theengineeraccelerator/Arduino-DDS/1 Product Definition/Feature Block Diagram.pdf

# DDS Tone Shield Feature Block Diagram Introduction:

This diagram shows the relationship between the different event
blocks that appear in the feature list. Dashed lines represent
device boundries, blocks that touch the device boundary are accessable by the user.

External Power
Power
Wired Signal
Wireless Signal

# KEY

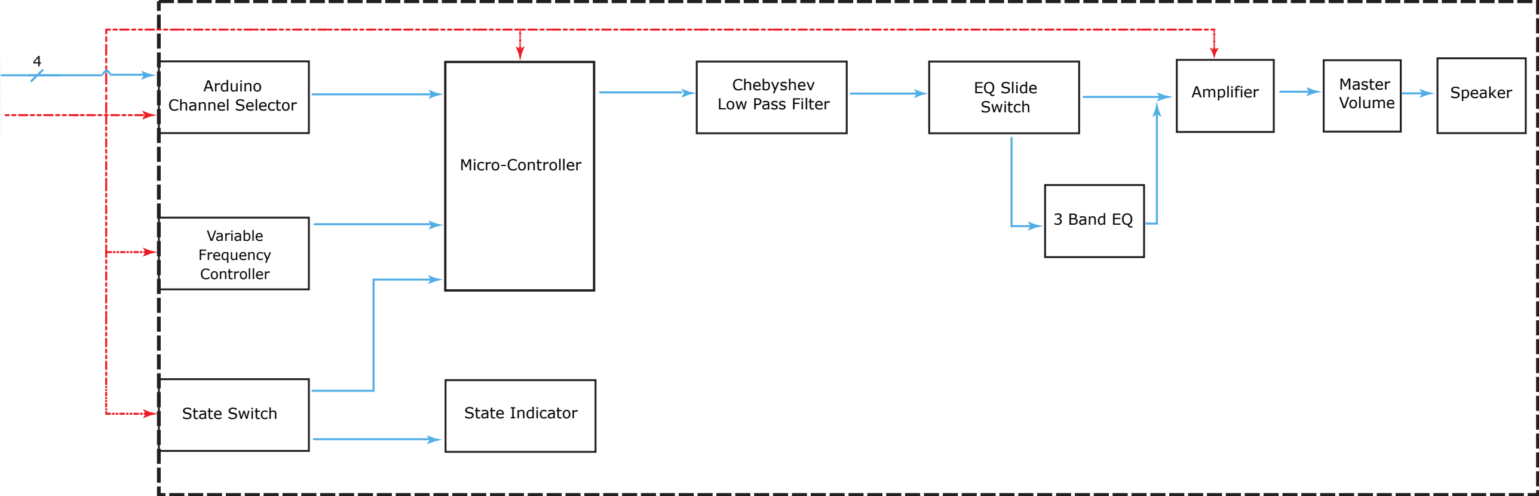
[picture p1: figure]
3 Band EQ; Arduino Channel Selector; Variable Frequency Controller; State Switch; Micro-Controller; State Indicator; Chebyshev Low Pass Filter; EQ Slide Switch; Amplifier; Speaker Master; Volume

Computer | Arduino Uno

## Circuit Board
