theengineeraccelerator/Arduino-DDS/2 Architecture/Product Architecture.xlsx

Sheet: Major Signals List
Project | Arduino DDS Breakout Board Hardware Block Diagram
Author | Zacher Tiburzi
Date | 2017-05-27
Verison | V_03
Name | Max Voltage | Current | Type | Max frequency | Copper Weight | Min Trace Width | Max length | Notes
Serial PC-Uno Signal | 5v |  | Digital | N/A
ATTiny Program 1 Signal | 5v | <10ma | Digital | 1kHz
ATTiny Program 2 Signal | 5v | <10ma | Digital | 1kHz
ATTiny Program 3 Signal | 5v | <10ma | Digital | 1kHz
ATTiny Program 4 Signal | 5v | <10ma | Digital | 1kHz
Uno Tone Signal 1 | 5v | <10ma | PWM | 1kHz
Uno Tone Signal 2 | 5v | <10ma | PWM | 1kHz
Uno Tone Signal 3 | 5v | <10ma | PWM | 1kHz
Uno Tone Signal 4 | 5v | <10ma | PWM | 1kHz
Uno Tone Signal Master | 5v | <10ma | PWM | 1kHz
DDS Tone Output Signal | 5v | <10ma | PWM | 320kHz
State LED Signal | 5v | <10ma | Digital | DC
On-Off State Signal | 5v | <10ma | Digital | DC
Var. Freq. Signal | 5v | <10ma | Digital | DC
LPF Signal Out | 5v | 10-40ma | Analog | 20khz
3 Band EQ Signal Out | 5v | 10-40ma | Analog | 20khz
Speaker Signal In | 2v | 25mA | Analog | 20khz
VCC | 5v | <10ma |  | DC
GND | 0v |  |  | DC

Sheet: Interface Pinouts
Project | Arduino DDS Breakout Board Hardware Block Diagram
Author | Zacher Tiburzi
Date | 2017-05-27
Verison | V_03
INTERFACE NAME
Pin Number | Pin Name | Connected Signal
Computer / Uno
1 | USB | Serial PC-Uno Signal
Uno / DDS Pin Interface
1 | Pin 13 | ATTiny Program 1 Signal
2 | Pin 12 | ATTiny Program 2 Signal
3 | Pin 11 | ATTiny Program 3 Signal
4 | Pin 10 | ATTiny Program 4 Signal
5 | Pin 9 | Uno Tone Signal 1
6 | Pin 6 | Uno Tone Signal 2
7 | Pin 5 | Uno Tone Signal 3
8 | Pin 3 | Uno Tone Signal 4
9 | VCC | VCC
10 | GND | GND
ATTIny85
1 | PB5 | ATTiny Program 4 Signal
2 | PB3 | Uno Tone Signal Master
3 | PB4 | DDS Tone Output Signal
4 | GND | GND
5 | PB0 | ATTiny Program 3 Signal / State LED Signal
6 | PB1 | ATTiny Program 2 Signal / On-Off State Signal
7 | PB2 | ATTiny Program 1 Signal / Var. Freq. Signal
8 | VCC | VCC

Sheet: Current Budget
Project | Arduino DDS Breakout Board Hardware Block Diagram
Author | Zacher Tiburzi
Date | 2017-05-27
Verison | V_03
 | Daily Duty Cycle | Current Draw [A] | Effective Avg Current [A] | Voltage Range
Attiny85 | 100% | 0.15 | 0.15 | 5v
LED | 100% | 0.02 | 0.02 | 1.4-1.9v
Var Freq POT | 50% | 0.1 | 0.05 | 1V - 5V
Push Button | 50% | 0.02 | 0.01 | 5V
Slide Switch | 100% | 0.025 | 0.025 | 5V
3 Band Eq | 50% | 0.1 | 0.05 | 6V
AMP | 100% | 0.055 | 0.055 | 6V
Total Current |  |  | 0.36

Sheet: Calculations
Project | Arduino DDS Breakout Board Hardware Block Diagram |  | Key
Author | Zacher Tiburzi |  | Inputs =
Date | 2017-05-27 |  | Outputs =
Verison | V_03
Perameters
ATTiny85 Pins (Page 161 on the atttiny85 document) | Pin output low voltage. With VCC= 5V Vout max = .6V
 | Pin output High voltage. With VCC= 5V Vout min = 4.3V
Outline of Signal Flow
1. Signal out of the ATTiny85 | 2. Signal into LPF | 3A. Wire | 4. Signal into Summing Amp | 5. Sgnal to speaker
 |  | 3B. Signal into EQ
Audio Range Notes
Sub Bass | 20 - 60
Bass | 60 - 250
Low Midrange | 250 - 500
Midrange | 500 - 2k
Upper Midrange | 2k - 4k |  |  |  |  | Random Calculations |  |  | Old Calculations
Presence | 4k - 6k |  |  |  |  | 555 Timer Frequency calculation |  |  | LPF Filter Component Design
Brilliance | 6k - 20k |  |  |  |  | R1 | 100 |  | f | 2000 | Hz
 |  |  |  |  |  | R2 | 1000 |  | R | 330 | Ω
 |  |  |  |  |  | C | 1e-07 |  | C | 2.2e-08 | F
1. Signal out of the ATTiny85 |  |  |  |  |  |  | t_high = .693(R1 + R2)C |  |  | f = 1 / (2πRC)
High voltage worst case 4.3V |  |  |  |  |  |  | t_low = .693(R2)C |  | f | 21922.81503 | Hz
Low voltage worst case .6V |  |  |  |  |  | t_high | 7.623e-05 |  | R | 3617.26448 | Ω
 |  |  |  |  |  | t_low | 6.93e-05 |  | C | 2.411509653e-07 | F
 |  |  |  |  |  |  | t = t_high + t_low
2. Signal into LPF |  |  |  |  |  | t | 0.00014553
CHebyChev Filter Component Design | http://www.rfcafe.com/references/electrical/filter-denorm.htm | http://www.calculatoredge.com/electronics/ch%20pi%20low%20pass.htm |  |  |  |  | f = 1 / t |  | LPF Voltage Output(V_High_Worst) | http://www.electronics-tutorials.ws/filter/filter_2.html |  | LPF Voltage Output(V_Low_Worst) | http://www.electronics-tutorials.ws/filter/filter_2.html
 |  |  |  |  |  | f | 6871.435443 |  | f | 2000 | Hz | f | 2000 | Hz
 |  |  |  |  |  |  |  |  | C | 2.2e-08 | F | C | 0.0000000220 | F
f_cuttoff | 12.5kHz |  |  |  |  |  |  |  |  | Xc = 1 / ((2πfC) |  |  | Xc = 1 / ((2πfC)
https://www-users.cs.york.ac.uk/~fisher/cgi-bin/lcfilter |  |  |  |  |  | Voltage Divider Analysis |  |  | Xc | 3617.26448 | Ω | Xc | 3617.26448 | Ω
http://interface.khm.de/index.php/lab/interfaces-advanced/arduino-dds-sinewave-generator/ |  | How much ripple can handle on an audio application. How much can human hear |  |  |  | Vin | 5 | V
 |  |  |  |  |  | R1 | 2 | kΩ | Vin | 4.3 | V | Vin | 0.6 | V
 |  |  |  |  |  | R2 | 2 | kΩ | R | 330 | Ω | R | 330 | Ω
3B. Signal into EQ | Note: Red tex indicates used values. |  |  |  |  |  | Vout = Vin(R2 / (R1+R2)) |  |  | Vout = Vin * (Xc / (R^2 + Xc^2)^.5) |  |  | Vout = Vin * (Xc / (R^2 + Xc^2)^.5)
LPF Filter Component Design |  |  |  |  |  | Vout | 2.5 | V | Vout | 4.282216993 | V | Vout | 0.5975186502 | V
f_cuttoff | 0 | Hz
R | 3900 | Ω
C | 2.2e-08 | F |  |  |  | Voltage Divider Design
 | f = 1 / (2πRC) |  |  |  |  | Vin | 12 | V
f_cuttoff | 1855.007426 | Hz |  |  |  | Vout | 6 | V
R | #DIV/0! | Ω |  |  |  | R2 | 5 | k
C | #DIV/0! | F |  |  |  |  | R1 = R2(Vin / Vout - 1)
 |  |  |  |  |  | R1 | 5 | k
HPF Filter Component Design
f_cuttoff | 0 | Hz |  |  |  | Ohm's Law
R | 1000 | Ω |  |  |  | V | 5 | V
C | 2.2e-08 | F |  |  |  | I | 0.001 | A
 | f = 1 / (2πRC) |  |  |  |  | R | 5 | Ω
f_cuttoff | 7234.52896 | Hz |  |  |  |  | V = I*R
R | #DIV/0! | Ω |  |  |  | V | 0.005 | V
C | #DIV/0! | F |  |  |  | I | 1 | A
 |  |  |  |  |  | R | 5000 | Ω
Cascade BPF Filter (LPF) Component Design
f_cuttoff | 0 | Hz |  |  |  | Power Calculation
R | 1000 | Ω |  |  |  | V | 5 | V
C | 2.2e-08 | F |  |  |  | I | 0.001 | A
 | f = 1 / (2πRC) |  |  |  |  | R | 330 | Ω
f_cuttoff | 7234.52896 | Hz |  |  |  |  | P = V*I
R | #DIV/0! | Ω |  |  |  | P | 0.005 | W
C | #DIV/0! | F |  |  |  |  | P = I^2*R
 |  |  |  |  |  | P | 0.00033 | W
 |  |  |  |  |  |  | P = V^2 / R
Cascade BPF Filter (HPF) Component Design |  |  |  |  |  | P | 0.07575757576 | W
f_cuttoff | 0 | Hz
R | 3900 | Ω
C | 2.2e-08 | F |  |  |  | op amp gain
 | f = 1 / (2πRC) |  |  |  |  | Rin | 680
f_cuttoff | 1855.007426 | Hz |  |  |  | Rf | 5000
R | #DIV/0! | Ω |  |  |  |  | A = Vout/Vin = Rf/Rin
C | #DIV/0! | F |  |  |  | A | 7.352941176
LPF Voltage Output (V_High_Worst) | http://www.electronics-tutorials.ws/filter/filter_2.html |  | LPF Voltage Output (V_Low_Worst) | http://www.electronics-tutorials.ws/filter/filter_2.html
f | 2000 | Hz | f | 2000 | Hz
C | 2.2e-08 | F | C | 2.2e-08 | F
 | Xc = 1 / ((2πfC) |  |  | Xc = 1 / ((2πfC)
Xc | 3617.26448 | Ω | Xc | 3617.26448 | Ω
Vin | 4.282216993 | V | Vin | 0.5975186502 | V
R | 3900 | Ω | R | 3900 | Ω
 | Vout = Vin * (Xc / (R^2 + Xc^2)^.5) |  |  | Vout = Vin * (Xc / (R^2 + Xc^2)^.5)
Vout | 2.912038666 | V | Vout | 0.4063309766 | V
HPF Voltage Output (V_High_Worst) | http://www.electronics-tutorials.ws/filter/filter_2.html |  | HPF Voltage Output (V_Low_Worst) | http://www.electronics-tutorials.ws/filter/filter_2.html
f | 2000 | Hz | f | 2000 | Hz
C | 2.2e-08 | F | C | 2.2e-08 | F
 | Xc = 1 / ((2πfC) |  |  | Xc = 1 / ((2πfC)
Xc | 3617.26448 | Ω | Xc | 3617.26448 | Ω
Vin | 4.282216993 | V | Vin | 0.5975186502 | V
R | 1000 | Ω | R | 1000 | Ω
 | Vout = Vin * (R / (R^2 + Xc^2)^.5) |  |  | Vout = Vin * (R / (R^2 + Xc^2)^.5)
Vout | 1.141028195 | V | Vout | 0.1592132365 | V
Cascade BPF Filter (LPF) Component Design (V_High_Worst) |  |  | Cascade BPF Filter (LPF) Component Design (V_Low_Worst)
f | 2000 | Hz | f | 2000 | Hz
C | 2.2e-08 | F | C | 2.2e-08 | F
 | Xc = 1 / ((2πfC) |  |  | Xc = 1 / ((2πfC)
Xc | 3617.26448 | Ω | Xc | 3617.26448 | Ω
Vin | 4.282216993 | V | Vin | 0.5975186502 | V
R | 1000 | Ω | R | 1000 | Ω
 | Vout = Vin * (Xc / (R^2 + Xc^2)^.5) |  |  | Vout = Vin * (Xc / (R^2 + Xc^2)^.5)
Vout | 4.12740076 | V | Vout | 0.5759163851 | V
f | 2000 | Hz | f | 2000 | Hz
C | 2.2e-08 | F | C | 2.2e-08 | F
 | Xc = 1 / ((2πfC) |  |  | Xc = 1 / ((2πfC)
Xc | 3617.26448 | Ω | Xc | 3617.26448 | Ω
Vin | 4.12740076 | V | Vin | 0.5975186502 | V
R | 3900 | Ω | R | 3900 | Ω
 | Vout = Vin * (R / (R^2 + Xc^2)^.5) |  |  | Vout = Vin * (R / (R^2 + Xc^2)^.5)
Vout | 3.026143021 | V | Vout | 0.4380909435 | V
4. Signal into Summing Amp
Single Signal (V_High_Worst) | Rf = 5k pot |  | Single Signal (V_Low_Worst) | Rf = 5k pot
V1 | 2.912038666 |  | V1 | 0.4063309766
V2 | 1.141028195 |  | V2 | 0.1592132365
V3 | 3.026143021 |  | V3 | 0.4380909435
V4 | 0 |  | V4 | 0
Rf | 500 | 5000 | Rf | 500 | 5000
Rin | 5600 |  | Rin | 3000
 | Vout = Rf/Rin(V1 + V2 + V3 + V4) |  |  | Vout = Rf/Rin(V1 + V2 + V3 + V4)
Vout | 0.6320723108 | 6.320723108 | Vout | 0.1672725261 | 1.672725261
EQ (V_High_Worst) | Rf = 5k pot |  | EQ (V_Low_Worst) | Rf = 5k pot
V1 | 0 |  | V1 | 0
V2 | 0 |  | V2 | 0
V3 | 0 |  | V3 | 0
V4 | 4.282216993 |  | V4 | 0.5975186502
Rf | 500 | 5000 | Rf | 500 | 5000
Rin | 3900 |  | Rin | 3000
 | Vout = Rf/Rin(V1 + V2 + V3 + V4) |  |  | Vout = Rf/Rin(V1 + V2 + V3 + V4)
Vout | 0.5490021786 | 5.490021786 | Vout | 0.0995864417 | 0.995864417
5. Length calculation
f_fund (max) | 36000 | Hz
f_harmonic (max) | 360000 | Hz
Copper Velocity factor | 0.643
Speed of light | 299792458 | m/s
Wavelength | 535 | m
 | speed = frequency • wavelength | m/s / 1 / s = m
f | 360311.3093 | Hz
length | 535.4626403 | meters
Safe length | 26.77313201 | Meters
