theengineeraccelerator/Arduino-DDS/2 Architecture/Archive/Product Architecture REV 02.xlsx

Sheet: Major Signals List
Project | Arduino DDS Breakout Board Hardware Block Diagram
Author | Douglas Bahr
Date | 2016-10-14
Verison | V_02
Name | Max Voltage | Current | Type | Max frequency | Copper Weight | Min Trace Width | Max length
Ardu to Tiny MainSignal | 5v | <10ma |  | 1hz
Tiny To Led Signal Out | 5v | 15ma |  | 20hz
Manual Frequency Signal | 5v | <10ma |  | 1kHz
Tiny DDS Signal Out | 5v | 25-40ma |  | 50kHz
Ard Sig header Pin 11 | 5v | <10ma |  | 1kHz
Ard Sig header Pin 10 | 5v | <10ma |  | 1kHz
Ard Sig header Pin 9 | 5v | <10ma |  | 1kHz
Ard Sig header Pin 4 | 5v | <10ma |  | 1kHz

Sheet: Pinouts
Project | Arduino DDS Breakout Board Hardware Block Diagram
Author | Douglas Bahr
Date | 2016-10-14
Verison | V_02
COMPONENT NAME | Pin Name
HDR1
 | io11
 | io10
 | io9
HDR4
 | io4
HDR2
 | VCC
 | GND
Attiny85
 | Tiny_2
 | Tiny_Vcc
 | Tiny_GND
DIP Switch
 | Dip_1
 | Dip_2
 | Dip_3
 | Dip_4
 | Dip_16
 | Dip_15
 | Dip_14
 | Dip_13

Sheet: Current Budget
Project | Arduino DDS Breakout Board Hardware Block Diagram
Author | Douglas Bahr
Date | 2016-10-14
Verison | V_02
 | Daily Duty Cycle | Current Draw [A] | Effective Avg Current [A] | Voltage Range
Attiny85 | 100% | 0.15 | 0.15 | 5v
LED | 100% | 0.02 | 0.02 | 1.4-1.9v
Total Current | 170ma

Sheet: Calculations
Project | Arduino DDS Breakout Board Hardware Block Diagram
Author | Douglas Bahr
Date | 2016-09-28
Verison | V_02
Attiny max out power | 100mw
Max draw | 200mw
power disapated by 5kpot |  | v/r = I across res | 5v/5000ohm | .001 I | P= i^2*R | 5nWatt
RC Low pass filter Cutoff 20KHz
 | 270 | ohm
 | 2.948808681e-08 | farad
 | 20000 | cutoff freq
 | 269.8710807
 |  | SOURCE
RC filter impedence |  | http://www.electronics-tutorials.ws/filter/filter_2.html
 | 381.746513 | Ohm
 |  | SOURCE
 |  | http://www.rfcafe.com/references/electrical/filter-denorm.htm
 | 8.691320734e-16 | Farad
 | 0.8202285378 | Henery | This seems to be completely off and discarded
 |  | http://www.calculatoredge.com/electronics/ch%20pi%20low%20pass.htm
Chebyshev Low pass filter calculations | l1 | 8.97512 | uH
 | l2 | 8.97512 | uH
 | c2 | 25.24322 | uF
 | c3 | 20.42218 | uF
