theengineeraccelerator/Arduino-DDS/2 Architecture/Archive/Product Architecture.xlsx

Sheet: Major Signals List
Project | Arduino DDS Breakout Board Hardware Block Diagram
Author | Douglas Bahr
Date | 2016-09-28
Verison | V_01
Name | Max Voltage | Current | Type | Max frequency | Copper Weight | Min Trace Width | Max length
Attiny85 | 6v | 200mA |  | 64mHz
DIP Switch | 24v | 100mA
Speaker | 5v | 20mA |  | 20KHZ
POT | 50 Vac | 10mA
On/On Switch | 28v | .4VA
LED | 1.7v | 50mA

Sheet: Pinouts
Project | Arduino DDS Breakout Board Hardware Block Diagram
Author | Douglas Bahr
Date | 2016-09-28
Verison | V_01
COMPONENT NAME
Pin Number | Pin Name
Attiny85 | Tiny_Power
 | Tiny_GND
 | Pot_In
 | On/on_IN
 | Sine_Out
DIP Switch | 11in
 | 10in
 | 9in
 | 3in
 | DIP_Out
Speaker | Speaker_Signal_Input
 | Speaker_Signal_Out
POT | Pot_Power
 | Pot_Gnd
 | Resistance_signal
On/On Switch | On/On_Power
 | On/On_Gnd
 | State
LED | Led_Power
 | Led_Gnd

Sheet: Current Budget
Project | Arduino DDS Breakout Board Hardware Block Diagram
Author | Douglas Bahr
Date | 2016-09-28
Verison | V_01
 | Daily Duty Cycle | Current Draw [A] | Effective Avg Current [A] | Voltage Range
Attiny85 | 100% | 0.15 | 0.15 | 5v
(Attiny might draw negligable current from its digital in pins. I don't know how attiny handles it)
Total Current | 150ma

Sheet: Calculations
Project | Arduino DDS Breakout Board Hardware Block Diagram
Author | Douglas Bahr
Date | 2016-09-28
Verison | V_01
Attiny max out power | 100mw
Max draw | 200mw
power disapated by 5kpot |  | v/r = I across res | 5v/5000ohm | .001 I | P= i^2*R | 5nWatt
 |  |  |  |  |  | http://www.electronics-tutorials.ws/filter/filter_2.html
 |  | rc
 |  | 270 | ohm |  | RC filter impedence
 |  | 2.948808681e-08 | farad |  | 381.746513
 |  | 20000 | cutoff freq
 |  |  |  | 8.691320734e-16 |  |  | 269.8710807
 |  |  |  | 0.8202285378
 |  |  |  |  | http://www.rfcafe.com/references/electrical/filter-denorm.htm
 | http://prntscr.com/cs9gem
 | l1 | 8.97512 | uH
 | l2 | 8.97512 | uH
 | c1 | 20.42218 | uf
 | c2 | 25.24322 | uf
 | c3 | 20.42218 | uf
