theengineeraccelerator/Arduino-DDS/1 Product Definition/Feature Block Diagram.png

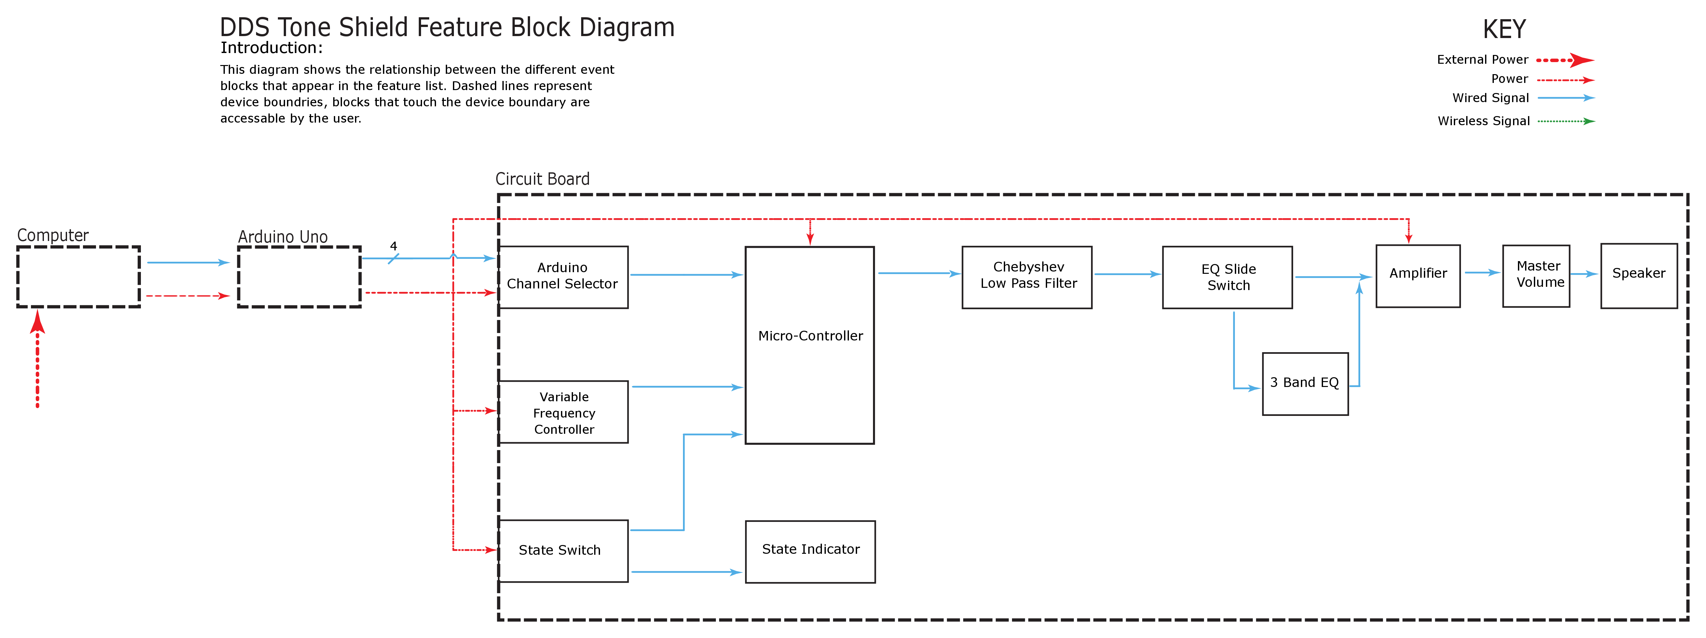
1 Product Definition/Feature Block Diagram.png
