theengineeraccelerator/Arduino-DDS/2 Architecture/Hardware Block Diagram.png

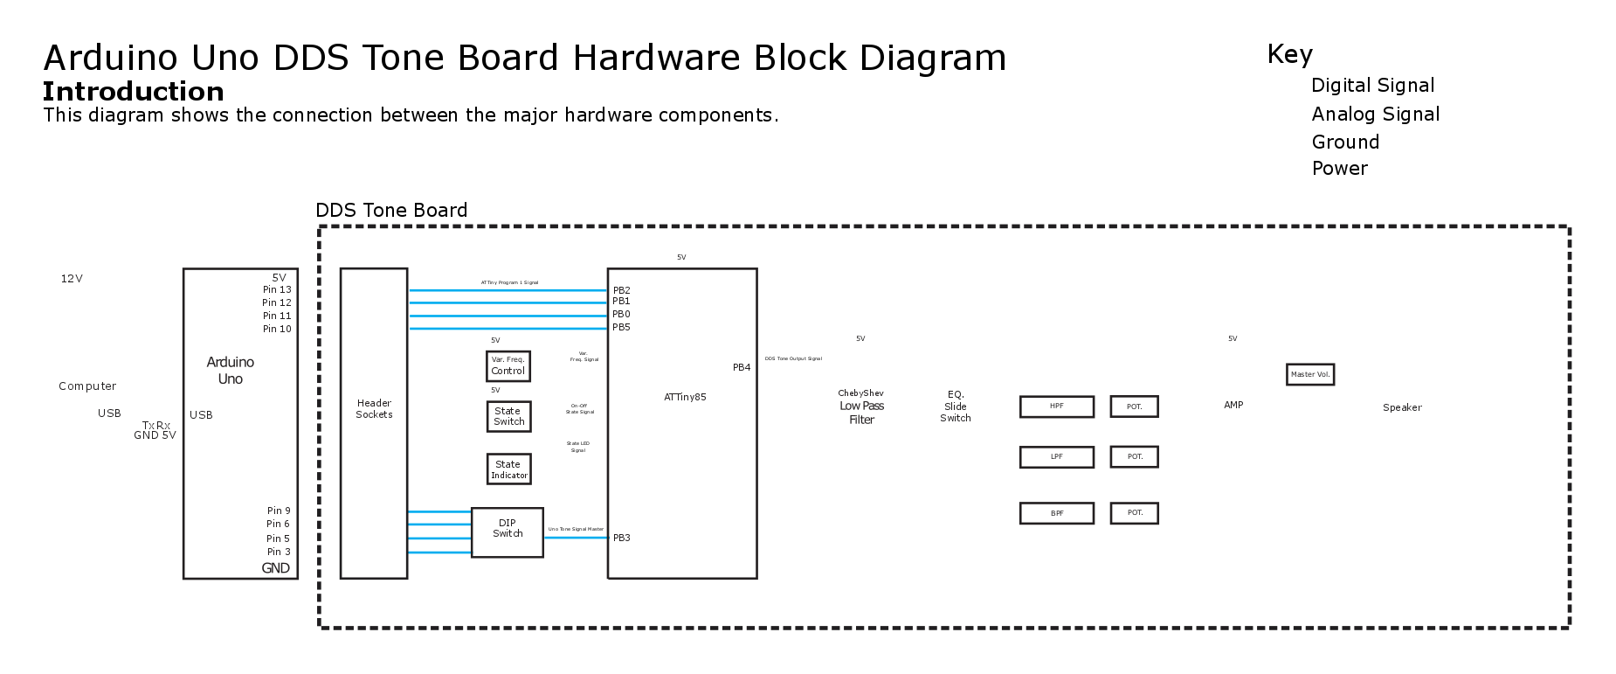
2 Architecture/Hardware Block Diagram.png
