theengineeraccelerator/Arduino-DDS/Art/490 5k fft.png

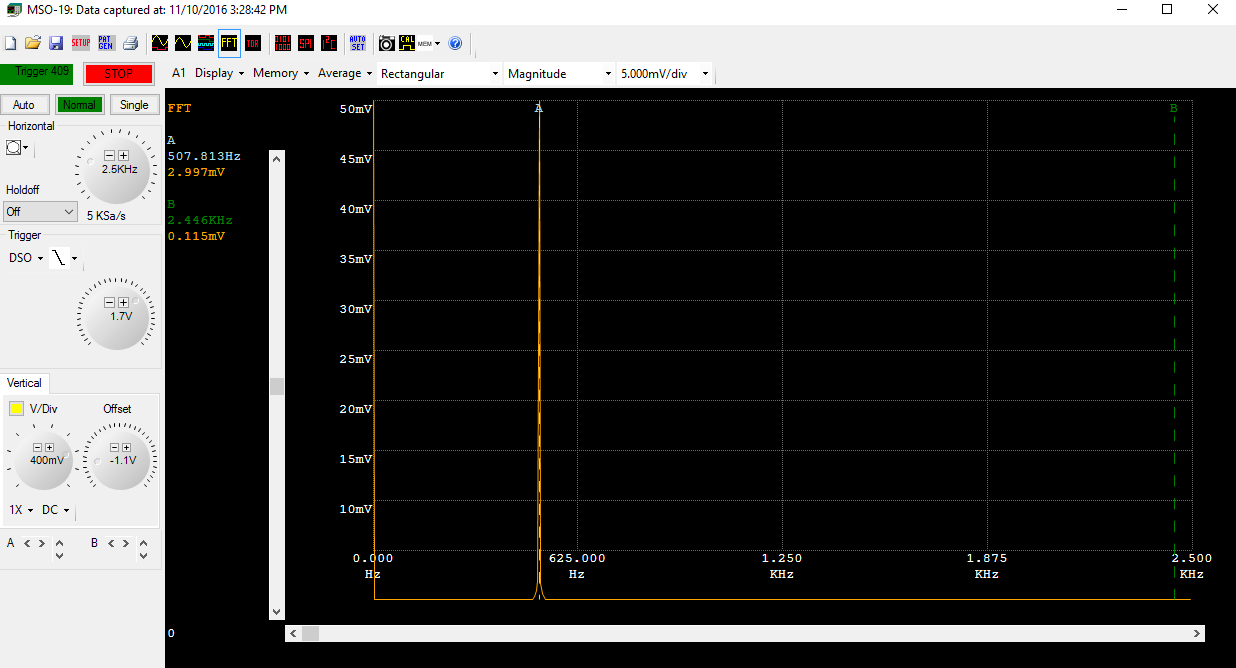
Art/490 5k fft.png
