theengineeraccelerator/Arduino-DDS/Art/490 500 fft.png

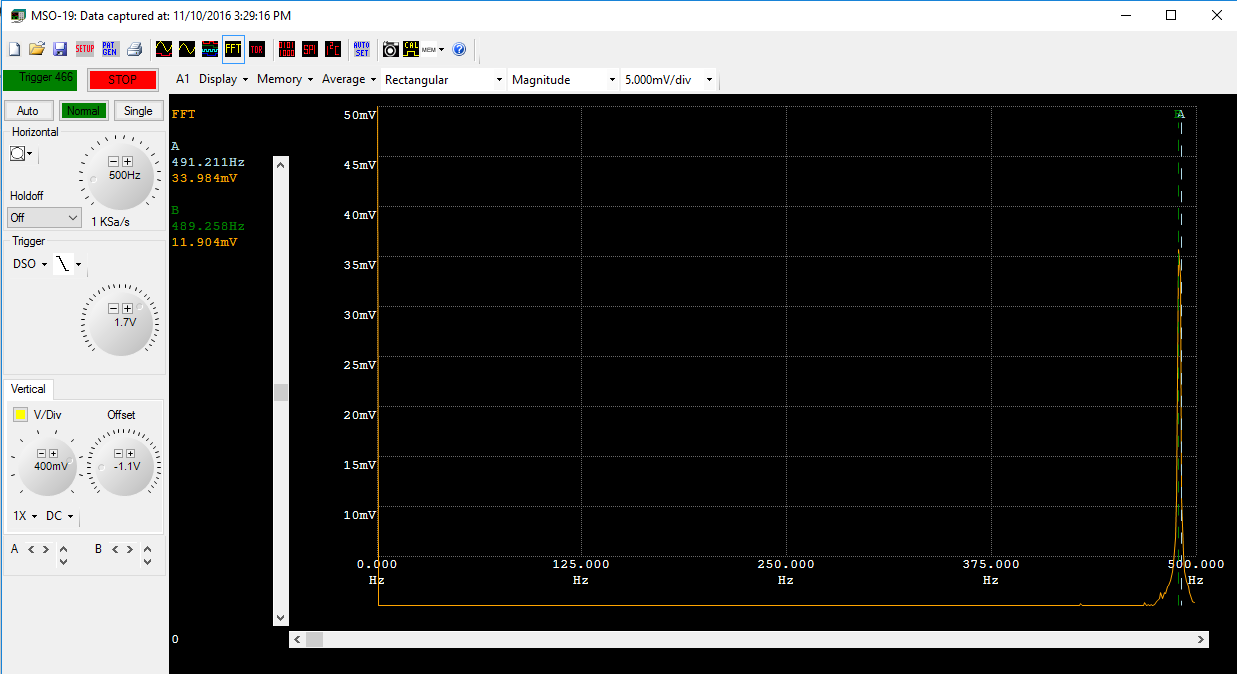
Art/490 500 fft.png
