theengineeraccelerator/Arduino-DDS/Art/490 500k fft.png

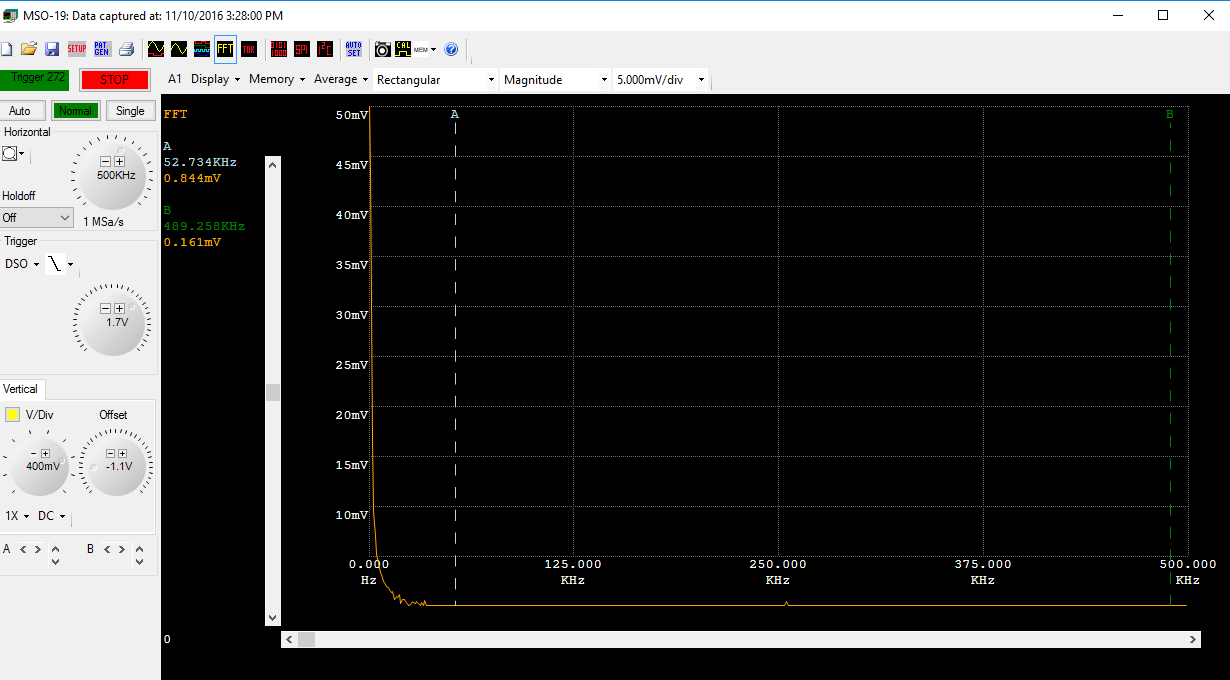
Art/490 500k fft.png
