theengineeraccelerator/Arduino-DDS/Art/490 hzScreenshot_1.png

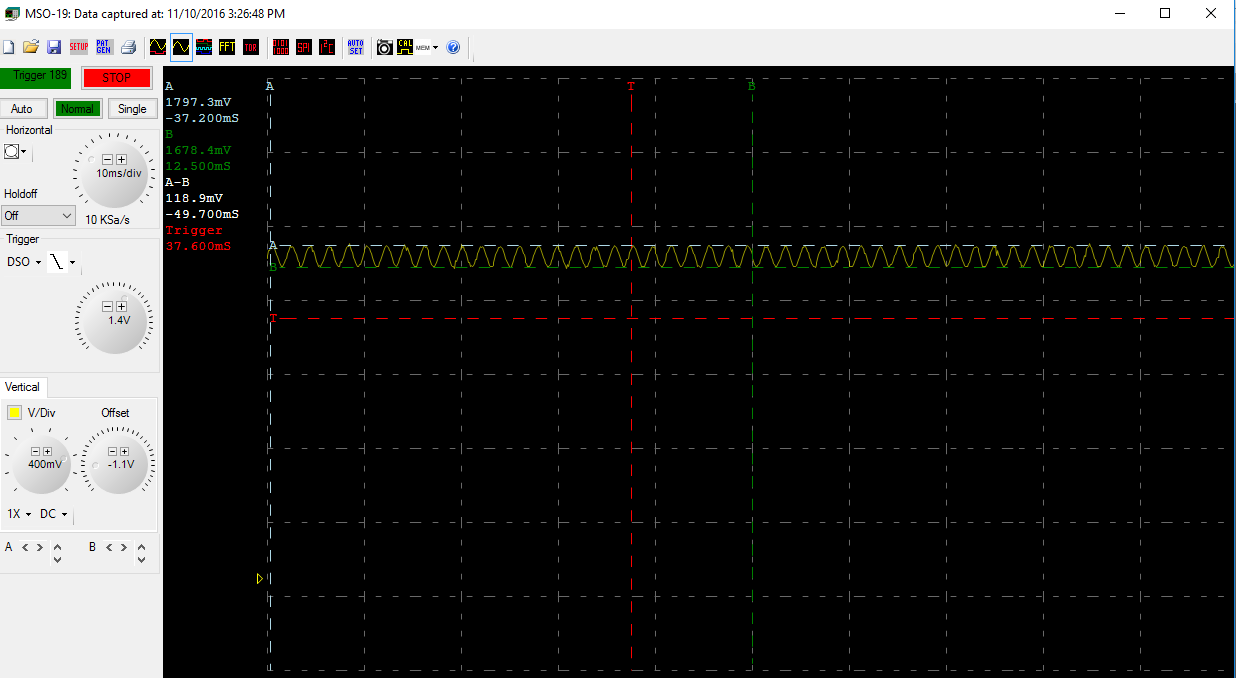
Art/490 hzScreenshot_1.png
