theengineeraccelerator/Arduino-DDS/2 Architecture/Major Component BOM.xlsx

Sheet: Major Components
Project | DDS Tone Shield |  |  |  |  |  |  |  | Key: | Finished
Author | Zacher Tiburzi |  |  |  |  |  |  |  |  | Needs an Eagle Library
Date | 42882 |  |  |  |  |  |  |  |  | Need to find Vendor part
Verison | Rev_4
Component | Voltage | Current | Tolerance | Wattage | Vendor | Vendor Part Number | Price | Qty | Manufacturer | MFG Part Number | Eagle Library: Device - Package | Invetory | URL | URL Refrence | URL Refrence
Arduino Uno Schield |  |  |  |  |  |  |  |  |  |  | ARDUINO_SHIELD - DUEMILANOVE_SHIELD | Yes
Headers that Match Arduino |  |  |  |  |  |  |  |  |  |  | CONN_6 - 1X6, CONN_8 - 1X8, CONN_10 - 1X10 | Yes | http://www.mouser.com/ProductDetail/SparkFun/PRT-11417/?qs=sGAEpiMZZMuWWq7rhECaKREdwluNxBetc4EOoXderyo%3d | https://www.sparkfun.com/products/11417
4 Pin Dip |  |  |  |  |  |  |  |  |  |  | DIP-04 - DIPSWITCH-04-SMD | Yes | http://www.mouser.com/ProductDetail/CTS-Electronic-Components/219-4MST/?qs=qNzHFtQhdJ8xGV2Z9mul9A%3D%3D | http://www.mouser.com/ProductDetail/Omron-Electronics/A6HF-4102/
Led |  |  |  |  |  |  |  |  |  |  | LED BLUE - 1206 - SMD1206 | Yes | http://www.mouser.com/ProductDetail/Lite-On/LTST-C150TBKT/?qs=V5GnFgTbEjKBpGvLUaHAfw%3D%3D | http://www.mouser.com/ProductDetail/Cree-Inc/XPGDRY-L1-0000-00501/ | https://www.digikey.com/product-detail/en/LTST-C150KRKT/160-1405-2-ND/386761
Pushbutton |  |  |  |  |  |  |  |  |  |  | PUSHBUTTON - 3CSH9_MEC_PUSHBUTTON | Yes | http://www.mouser.com/ProductDetail/MEC-Switches/3CSH9/
ATTiny |  |  |  |  |  |  |  |  |  |  | ATTINY85 - PDIP08_300MIL | Yes | http://www.mouser.com/ProductDetail/Atmel/ATtiny85-20PU/?qs=8jWQYweyg6NCiiaOb5GI9Q%3D%3D
Amp LM386N-1 |  |  |  |  |  |  |  |  |  |  | LM386 - DIP08 | Yes | http://www.mouser.com/ProductDetail/Texas-Instruments/LM386N-1-NOPB/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
ATTiny / Amp Connector |  |  |  |  |  |  |  |  |  |  | CONN_4 - 1X4 | Yes | http://www.mouser.com/ProductDetail/Mill-Max/110-44-308-41-001000/ | http://www.mouser.com/ProductDetail/Harwin/M22-7130642/ | http://www.mouser.com/Search/ProductDetail.aspx?qs=ulE8k0yEMYbeS53C36LLIQ%3d%3d | http://www.mouser.com/ProductDetail/SparkFun/PRT-00115/?qs=WyAARYrbSnbK8S6xiDKwZg%3D%3D
slide switch |  |  |  |  |  |  |  |  |  |  | SWITCH-SPDT - JS102011SCQN | Yes | http://www.mouser.com/ProductDetail/CK-Components/JS102011SCQN/?qs=aIxPIZZxLh%2FC%2Fw7UJtfwsg%3D%3D | http://www.mouser.com/ProductDetail/CK-Components/JS202011SCQN/
Speaker Jumper |  |  |  |  |  |  |  |  |  |  | CONN_2 - 1X2 | Yes | http://www.mouser.com/ProductDetail/3M-Electronic-Solutions-Division/929870-01-02-RA/
Speaker |  |  |  |  |  |  |  |  |  |  | SPEAKER - CSS40408N | Yes | http://www.mouser.com/ProductDetail/CUI/CSS-40408N/
Pot 5k |  |  |  |  |  |  |  |  |  |  | POT1 - Rk09 | Yes | http://www.mouser.com/ProductDetail/ALPS/RK09K1130AU2/?qs=sGAEpiMZZMtC25l1F4XBU3JeeCo7XMTlDNJzm3UqYmI%3d | http://www.mouser.com/ProductDetail/ALPS/RK09L1140A2U/?qs=sGAEpiMZZMtC25l1F4XBU3JeeCo7XMTlNRqBfUrZdf0%3d
Pot 10k |  |  |  |  |  |  |  |  |  |  | POT1 - Rk09 | Yes | http://www.mouser.com/ProductDetail/ALPS/RK09K1130AJ3/?qs=sGAEpiMZZMtC25l1F4XBU3JeeCo7XMTlfiaf8FqSguo%3d |  | http://www.mouser.com/ProductDetail/ALPS/RK09L1140A65/?qs=sGAEpiMZZMtC25l1F4XBUyOcKw5CnqLBmPAtssq3n28%3d
POT 100k |  |  |  |  |  |  |  |  |  |  | POT2 - 5150500311 | TODO | http://www.mouser.com/ProductDetail/ALPS/RK09D113AF25A15/ | http://www.mouser.com/ProductDetail/TE-Connectivity/5150500311/
Res 2200 |  |  |  |  |  |  |  |  |  |  | RESISTOR - 1206 | Yes | http://www.mouser.com/ProductDetail/Vishay/CRCW12062K20JNEA/
Res 330 |  |  |  |  |  |  |  |  |  |  | RESISTOR - 1206 | Yes | http://www.mouser.com/ProductDetail/Vishay/CRCW1206330RJNEB/?qs=sGAEpiMZZMvdGkrng054t1VbmbR8V6nMPxFPu6gLR8M%3d | http://www.mouser.com/ProductDetail/Vishay/CRCW2512330RJNEG/
Res 3900 |  |  |  |  |  |  |  |  |  |  | RESISTOR - 1206 | Yes | http://www.mouser.com/ProductDetail/Vishay/CRCW12063K90JNEA/?qs=sGAEpiMZZMvdGkrng054txEw7b1YnvGu19MLK7JIJYQ%3d | http://www.mouser.com/ProductDetail/Vishay/CRCW25123K90JNEG/
Res 1000 |  |  |  |  |  |  |  |  |  |  | RESISTOR - 1206 | Yes | http://www.mouser.com/ProductDetail/Vishay/CRCW12061K00JNEB/ | http://www.mouser.com/ProductDetail/Vishay/CRCW25121K00JNEG/
Res 5600 |  |  |  |  |  |  |  |  |  |  | RESISTOR - 1206 | Yes | http://www.mouser.com/ProductDetail/Vishay/CRCW12065K60JNEB/?qs=sGAEpiMZZMvdGkrng054txEw7b1YnvGuJI6O9VwCEo8%3d | http://www.mouser.com/ProductDetail/Vishay/CRCW25125K60JNEG/?qs=sGAEpiMZZMtlubZbdhIBIKccH9tYRGHhxWVoSRHblPQ%3d
Res 270 |  |  |  |  |  |  |  |  |  |  | RESISTOR - 1206 | Yes | http://www.mouser.com/ProductDetail/Vishay/CRCW1206270RJNEB/
Capacitor 22NF |  |  |  |  |  |  |  |  |  |  | CAP_POL - EIA3216 | Yes | http://www.mouser.com/ProductDetail/KEMET/C1206C223J1RACTU/ | http://www.mouser.com/ProductDetail/KEMET/C0402C222J8JACTU/?qs=sGAEpiMZZMuMW9TJLBQkXpko7Z6FbucJaU3OOvany2c%3d
Capacitor .1uF | 100nF |  |  |  |  |  |  |  |  |  |  | CAP_POL - EIA3216 | Yes | http://www.mouser.com/ProductDetail/KEMET/C1206C104K5RACTU/
Cap 47nf |  |  |  |  |  |  |  |  |  |  | CAP_POL - EIA3216 | Yes | http://www.mouser.com/ProductDetail/KEMET/C1206C473K5RAC/?qs=sGAEpiMZZMvsSlwiRhF8qiXSXURM2pKqAgxNh0rYBeU%3d
Ind 4.7mh |  |  |  |  |  |  |  |  |  |  | INDUCTOR - SDR0805-472KL | Yes | http://www.mouser.com/ProductDetail/Bourns/SDR0503-472JL/
 | notes
 | Convert between time and frequency domain
 | construct any signal out of sin and cos
 | the filted removes the n order harmonics so se end up with one.
 | Use a bunch of pulses going wide and long to create a sine wave.
 | Cheby removes the extra harmonics

Sheet: Component Comparision
Project | DDS Tone Shield |  |  |  | NOTE: Add more characteristic categories as needed
Author | Zacher Tiburzi
Date | 2017-05-27
Verison | Rev_4
Component | Voltage | Current | Tolerance | Wattage | Characteristic 1 | Characteristic 2 | Characteristic 3 | Vendor | Vendor Part Number | Price | Qty | Lead Time | Manufacturer | MFG Part Number
Speaker | 5V | 20mA |  | .1w | Mouser | 490-GF0401M | 4.81 | 1 | CUI | GF0401M
Speaker | 2V | .25A |  | .5W | Mouser | CLS0231MA-1-L152
Notes: RLC Filter Components
 | R | C | Pot |  | R | C | L | Pot
LPF |  |  |  |  | 270 | 47nF | 4.7mH
 |  |  |  |  |  | 100nF | 4.7mH
 |  |  |  |  |  | 47nF
 |  |  |  |  | 270 |  |  | 100k
LPF | 3900 | 22NF | 10K
HPF | 1000 | 22NF | 10K
BPF | 3900 | 22NF | 10K
 | 1000 | 22NF
AMP | 2200
 | 2200
 | 2200
 | 5K
