theengineeraccelerator/Arduino-DDS/2 Architecture/Archive/DDS Tone Shield Major Component BOM  REV 03.xlsx

Sheet: Major Components
Project | DDS Tone Shield
Author | Douglas Bahr
Date | 2016-10-14
Verison | Rev_3
Component | Voltage | Current | Tolerance | Wattage | Vendor | Vendor Part Number | Price | Qty | Manufacturer | MFG Part Number
Attiny85 | 5.5v | 200ma | NA | 1W | Mouser | 556-ATTINY85-20PU | 2.35 | 1 | Atmel (http://www.mouser.com/atmel/) | ATtiny85-20PU
Switch | 28v |  | na |  | Mouser | 633-BB16APFA | 4.15 | 1 | NKK Switches (http://www.mouser.com/NKK-Switches/) | BB16AP-FA
5k Pot | 25v |  | 20% | 50mw | Mouser | 858-P120PK-F20BR5K | 0.26 | 1 | BI Technologies / TT Electronics (http://www.mouser.com/BI-Technologies/) | P120PK-F20BR5K
Speaker | 5V | 20mA |  | .1w | Mouser | 490-GF0401M | 4.81 | 1 | CUI | GF0401M
DipSwitch | 50v | 100 |  |  | Mouser | 611-TDA08H0SB1R | 2.88 | 1 | C&K Components (http://www.mouser.com/ckcomponents/) | TDA08H0SB1R
100k pot | 25v |  |  | 200mW | Mouser | 279-5150500311 | 1.97 | 1 | TE Connectivity / Holsworthy (http://www.mouser.com/TE-Holsworthy/) | 5150500311
 |  |  |  |  |  | Total | 14.45

Sheet: Component Comparision
Project |  |  |  |  | NOTE: Add more characteristic categories as needed
Author
Date
Verison
Component | Voltage | Current | Tolerance | Wattage | Characteristic 1 | Characteristic 2 | Characteristic 3 | Vendor | Vendor Part Number | Price | Qty | Lead Time | Manufacturer | MFG Part Number
