theengineeraccelerator/Arduino-DDS/2 Architecture/BOM__rev_2.xlsx

Sheet: Major Components
Project | DDS Tone Shield
Author | Douglas Bahr
Date | 2016-10-20
Verison | Rev_3
Component | Voltage | Current | Tolerance | Wattage | Vendor | Vendor Part Number | Price | Qty | TOTAL | Manufacturer | MFG Part Number | Web
10 uH Inductor |  | 230 mA | 10% |  | Mouser | 871-B78108T1103K | 0.39 | 2 | 0.78 | EPCOS / TDK (http://www.mouser.com/EPCOS/) | B78108T1103K | http://www.mouser.com/ProductDetail/EPCOS-TDK/B78108T1103K/
4.7uH Inductor |  | 530 mA | 5% |  | Mouser | 542-78F4R7-RC | 0.22 | 2 | 0.44 | Bourns (http://www.mouser.com/bourns/) | 78F4R7J-RC | http://www.mouser.com/ProductDetail/Bourns/78F4R7J-RC/
100 pf capacitor | 25 VDC |  | 5% |  | Mouser | 77-VJ1206A101JXXPBC | 0.1 | 3 | 0.3 | Vishay / Vitramon | VJ1206A101JXXPW1BC | http://www.mouser.com/ProductDetail/Vishay-Vitramon/VJ1206A101JXXPW1BC/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
47nF capacitor | 16 VDC |  | 10% |  | Mouser | 77-VJ1206Y473KXJPBC | 0.1 | 2 | 0.2 | Vishay / Vitramon | VJ1206Y473KXJPW1BC | http://www.mouser.com/ProductDetail/Vishay-Vitramon/VJ1206Y473KXJPW1BC/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
100nF capacitor | 50v |  | 10% |  | Mouser | 581-12065C104K | 0.1 | 1 | 0.1 | AVX | 12065C104KAT2A | http://www.mouser.com/ProductDetail/AVX/12065C104KAT2A/?qs=sGAEpiMZZMs0AnBnWHyRQMaLe2bV4MePwTw1OreXLjM%3d
100k pot | 25v |  |  | 200mW | Mouser | 279-5150500311 | 1.97 | 1 | 1.97 | TE Connectivity / Holsworthy (http://www.mouser.com/TE-Holsworthy/) | 5150500311 | http://www.mouser.com/ProductDetail/TE-Connectivity/5150500311/
 |  |  |  |  |  |  |  |  | Total
 |  |  |  |  |  |  |  |  | 3.79

Sheet: Component Comparision
Project |  |  |  |  | NOTE: Add more characteristic categories as needed
Author
Date
Verison
Component | Voltage | Current | Tolerance | Wattage | Characteristic 1 | Characteristic 2 | Characteristic 3 | Vendor | Vendor Part Number | Price | Qty | Lead Time | Manufacturer | MFG Part Number
