theengineeraccelerator/Arduino-DDS/3 Realization/BOM/Working BOM Template.xlsx

Sheet: Eagle Internal BOM
Part | Value | DESCRIPTION | MANUFACTURER | MFG_PART_NUM | PACKAGE | VENDOR | VENDOR_PART_NUM

Sheet: Working BOM
Part | Value | Description | Manufacturer | MFG_Part_Number | Package | Vendor | Vendor_Part_num

Sheet: Back Annotation Script
CHANGE DISPLAY OFF; | Attribute Description ''; | Attribute Manufacturer ''; | Attribute MFG_Part_Number ''; | Attribute Package ''; | Attribute Vendor ''; | Attribute Vendor_Part_num '';
CHANGE DISPLAY OFF; | Attribute Description ''; | Attribute Manufacturer ''; | Attribute MFG_Part_Number ''; | Attribute Package ''; | Attribute Vendor ''; | Attribute Vendor_Part_num '';
CHANGE DISPLAY OFF; | Attribute Description ''; | Attribute Manufacturer ''; | Attribute MFG_Part_Number ''; | Attribute Package ''; | Attribute Vendor ''; | Attribute Vendor_Part_num '';
CHANGE DISPLAY OFF; | Attribute Description ''; | Attribute Manufacturer ''; | Attribute MFG_Part_Number ''; | Attribute Package ''; | Attribute Vendor ''; | Attribute Vendor_Part_num '';
CHANGE DISPLAY OFF; | Attribute Description ''; | Attribute Manufacturer ''; | Attribute MFG_Part_Number ''; | Attribute Package ''; | Attribute Vendor ''; | Attribute Vendor_Part_num '';
CHANGE DISPLAY OFF; | Attribute Description ''; | Attribute Manufacturer ''; | Attribute MFG_Part_Number ''; | Attribute Package ''; | Attribute Vendor ''; | Attribute Vendor_Part_num '';
CHANGE DISPLAY OFF; | Attribute Description ''; | Attribute Manufacturer ''; | Attribute MFG_Part_Number ''; | Attribute Package ''; | Attribute Vendor ''; | Attribute Vendor_Part_num '';
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
CHANGE DISPLAY OFF; | Attribute Description ''; | Attribute Manufacturer ''; | Attribute MFG_Part_Number ''; | Attribute Package ''; | Attribute Vendor ''; | Attribute Vendor_Part_num '';
