theengineeraccelerator/Arduino-DDS/3 Realization/Command List Template.xlsx

Sheet: SMS Construction
SMS Construction
Fields | @ | int-msg # | “ “ | byte part | “ “ | byte:Total Parts | : | char: payload | !
Range |  | 0 - 999 |  | 0 - 2 |  | 1 - 3 |  | 0 - 151 characters
Example Construction | @ | 21 | “ “ | 0 | “ “ | 1 | : | CFG 357541000485583 | !
Sent SMS | @21 0 1:CFG 357541000485583!

Sheet: SMS formats
XXX <-> YYY Command List
Author
Date
Version
Key: |  |  | General parsing characters |  |  |  | NOTE: | “ “: means a whitespace character
 |  |  | “ “ | Command End
 |  |  | ; | record separator
 |  |  | , | non time field separator
 |  |  | / | time separator
COMMAND NAME |  |  | Report Date
Fields | RPT | “ “ | int:day | / | int:month | / | int:year | ;
 |  |  |  |  |  |  |  |  | char reason | , | int:day | / | int:month | / | int:year | , | int: item-id | , | char:lot-id | , | int:qty
Range |  |  | 0 - 31 |  | 0 - 12 |  | 00 - 99 |  | USE,WST, EXP,INC,DEC |  | 0 - 31 |  | 0 - 12 |  | 00 - 99 |  | See Inventory ID Table |  | See Lot Id format |  | 0 - 999999
 |  |  |  |  |  |  |  |  | OR
 |  |  |  |  |  |  |  |  | RCV,SNT |  |  |  |  |  |  |  | int: to/from locn-id? |  | char:ship-id?
Range |  |  |  |  |  |  |  |  |  |  |  |  |  |  |  |  | 0 - 32,000 |  | See ship voucher format | ,
Example Construction | RPT | “ “ | 30 | / | 04 | / | 12 | ; | USE | , | 29 | / | 04 | / | 12 | , | 01 | , | 320 | , | 10
 |  |  |  |  |  |  |  | ; | USE | , | 24 | / | 04 | / | 12 | , | 04 | , | V-JM-010211E | , | 5
 |  |  |  |  |  |  |  | ; | RCV | , | 10 | / | 04 | / | 12 | , | 03 | , | X11064 | , | -1
Sent SMS | RPT 30/04/12;USE,29/04/12,01,320,10;USE,24/04/12,04,V-JM-010211E,5;RCV,10/04/12,03,X11064,-1
Notes | For The SNT case the first field is the location the shipment was sent to and in the RCV case the first field is the location the shipment was received from
