theengineeraccelerator/Arduino-DDS/3 Realization/IC Tables.xlsx

 | create pads | smd .1 .1 '1
Pad | Name | Rename Pins | X Coord | Y Coord | Move Pads | Connect Pins
1 | A | name 1 A; | 0.2 | 0.4 | move 1 (0.2 0.4); | Connect G$1.A 1;
2 | B | name 2 B; | 0.3 | 0.7 | move 2 (0.3 0.7); | Connect G$1.B 2;
3 | C | name 3 C; | 0.4 | 1.4 | move 3 (0.4 1.4); | Connect G$1.C 3;
4 | D | name 4 D; | 0.5 | 1.7 | move 4 (0.5 1.7); | Connect G$1.D 4;
5 | A | name 5 A; | 0.6 | 2.4 | move 5 (0.6 2.4); | Connect G$1.A 5;
6 | B | name 6 B; | 0.7 | 2.7 | move 6 (0.7 2.7); | Connect G$1.B 6;
7 | C | name 7 C; | 0.8 | 3.4 | move 7 (0.8 3.4); | Connect G$1.C 7;
8 | D | name 8 D; | 0.9 | 3.7 | move 8 (0.9 3.7); | Connect G$1.D 8;
9 | A | name 9 A; | 1.0 | 4.4 | move 9 (1 4.4); | Connect G$1.A 9;
10 | B | name 10 B; | 1.1 | 4.7 | move 10 (1.1 4.7); | Connect G$1.B 10;
11 | C | name 11 C; | 1.2 | 5.4 | move 11 (1.2 5.4); | Connect G$1.C 11;
12 | D | name 12 D; | 1.3 | 5.7 | move 12 (1.3 5.7); | Connect G$1.D 12;
13 | A | name 13 A; | 1.4 | 6.4 | move 13 (1.4 6.4); | Connect G$1.A 13;
14 | B | name 14 B; | 1.5 | 6.7 | move 14 (1.5 6.7); | Connect G$1.B 14;
15 | C | name 15 C; | 1.6 | 7.4 | move 15 (1.6 7.4); | Connect G$1.C 15;
16 | D | name 16 D; | 1.7 | 7.7 | move 16 (1.7 7.7); | Connect G$1.D 16;
17 | A | name 17 A; | 1.8 | 8.4 | move 17 (1.8 8.4); | Connect G$1.A 17;
18 | B | name 18 B; | 1.9 | 8.7 | move 18 (1.9 8.7); | Connect G$1.B 18;
19 | C | name 19 C; | 2.0 | 9.4 | move 19 (2 9.4); | Connect G$1.C 19;
20 | D | name 20 D; | 2.1 | 9.7 | move 20 (2.1 9.7); | Connect G$1.D 20;
21 | A | name 21 A; | 2.2 | 10.4 | move 21 (2.2 10.4); | Connect G$1.A 21;
22 | B | name 22 B; | 2.3 | 10.7 | move 22 (2.3 10.7); | Connect G$1.B 22;
23 | C | name 23 C; | 2.4 | 11.4 | move 23 (2.4 11.4); | Connect G$1.C 23;
24 | D | name 24 D; | 2.5 | 11.7 | move 24 (2.5 11.7); | Connect G$1.D 24;
25 | A | name 25 A; | 2.6 | 12.4 | move 25 (2.6 12.4); | Connect G$1.A 25;
26 | B | name 26 B; | 2.7 | 12.7 | move 26 (2.7 12.7); | Connect G$1.B 26;
27 | C | name 27 C; | 2.8 | 13.4 | move 27 (2.8 13.4); | Connect G$1.C 27;
28 | D | name 28 D; | 2.9 | 13.7 | move 28 (2.9 13.7); | Connect G$1.D 28;
29 | A | name 29 A; | 3.0 | 14.4 | move 29 (3 14.4); | Connect G$1.A 29;
30 | B | name 30 B; | 3.1 | 14.7 | move 30 (3.1 14.7); | Connect G$1.B 30;
31 | C | name 31 C; | 3.2 | 15.4 | move 31 (3.2 15.4); | Connect G$1.C 31;
32 | D | name 32 D; | 3.3 | 15.7 | move 32 (3.3 15.7); | Connect G$1.D 32;
33 | A | name 33 A; | 3.4 | 15.4 | move 33 (3.4 15.4); | Connect G$1.A 33;
34 | B | name 34 B; | 3.5 | 15.7 | move 34 (3.5 15.7); | Connect G$1.B 34;
35 | C | name 35 C; | 3.6 | 16.4 | move 35 (3.6 16.4); | Connect G$1.C 35;
36 | D | name 36 D; | 3.7 | 16.7 | move 36 (3.7 16.7); | Connect G$1.D 36;
37 | A | name 37 A; | 3.8 | 16.4 | move 37 (3.8 16.4); | Connect G$1.A 37;
38 | B | name 38 B; | 3.9 | 16.7 | move 38 (3.9 16.7); | Connect G$1.B 38;
39 | C | name 39 C; | 4.0 | 17.4 | move 39 (4 17.4); | Connect G$1.C 39;
40 | D | name 40 D; | 4.1 | 17.7 | move 40 (4.1 17.7); | Connect G$1.D 40;
41 | A | name 41 A; | 4.2 | 17.4 | move 41 (4.2 17.4); | Connect G$1.A 41;
42 | B | name 42 B; | 4.3 | 17.7 | move 42 (4.3 17.7); | Connect G$1.B 42;
43 | C | name 43 C; | 4.4 | 18.4 | move 43 (4.4 18.4); | Connect G$1.C 43;
44 | D | name 44 D; | 4.5 | 18.7 | move 44 (4.5 18.7); | Connect G$1.D 44;
45 | A | name 45 A; | 4.6 | 18.4 | move 45 (4.6 18.4); | Connect G$1.A 45;
46 | B | name 46 B; | 4.7 | 18.7 | move 46 (4.7 18.7); | Connect G$1.B 46;
47 | C | name 47 C; | 4.8 | 19.4 | move 47 (4.8 19.4); | Connect G$1.C 47;
48 | D | name 48 D; | 4.9 | 19.7 | move 48 (4.9 19.7); | Connect G$1.D 48;
49 | A | name 49 A; | 5.0 | 19.4 | move 49 (5 19.4); | Connect G$1.A 49;
50 | B | name 50 B; | 5.1 | 19.7 | move 50 (5.1 19.7); | Connect G$1.B 50;
51 | C | name 51 C; | 5.2 | 20.4 | move 51 (5.2 20.4); | Connect G$1.C 51;
52 | D | name 52 D; | 5.3 | 20.7 | move 52 (5.3 20.7); | Connect G$1.D 52;
53 | A | name 53 A; | 5.4 | 20.4 | move 53 (5.4 20.4); | Connect G$1.A 53;
54 | B | name 54 B; | 5.5 | 20.7 | move 54 (5.5 20.7); | Connect G$1.B 54;
55 | C | name 55 C; | 5.6 | 21.4 | move 55 (5.6 21.4); | Connect G$1.C 55;
56 | D | name 56 D; | 5.7 | 21.7 | move 56 (5.7 21.7); | Connect G$1.D 56;
57 | A | name 57 A; | 5.8 | 21.4 | move 57 (5.8 21.4); | Connect G$1.A 57;
58 | B | name 58 B; | 5.9 | 21.7 | move 58 (5.9 21.7); | Connect G$1.B 58;
59 | C | name 59 C; | 6.0 | 22.4 | move 59 (6 22.4); | Connect G$1.C 59;
60 | D | name 60 D; | 6.1 | 22.7 | move 60 (6.1 22.7); | Connect G$1.D 60;
61 | A | name 61 A; | 6.2 | 22.4 | move 61 (6.2 22.4); | Connect G$1.A 61;
62 | B | name 62 B; | 6.3 | 22.7 | move 62 (6.3 22.7); | Connect G$1.B 62;
63 | C | name 63 C; | 6.4 | 23.4 | move 63 (6.4 23.4); | Connect G$1.C 63;
64 | C | name 64 C; | 6.5 | 23.4 | move 64 (6.5 23.4); | Connect G$1.C 64;
