theengineeraccelerator/Arduino-DDS/(list of files, cad)

Other CAD files:
3 Realization/ArduinoUnoShield.dwg
4 Realization/ArduinoUnoShield.dwg
3 Realization/Archive 1/ArduinoUnoShield.dwg
