theengineeraccelerator/Arduino-DDS/3 Realization/Manufacturing Package/Preview/Layout Rev1.png

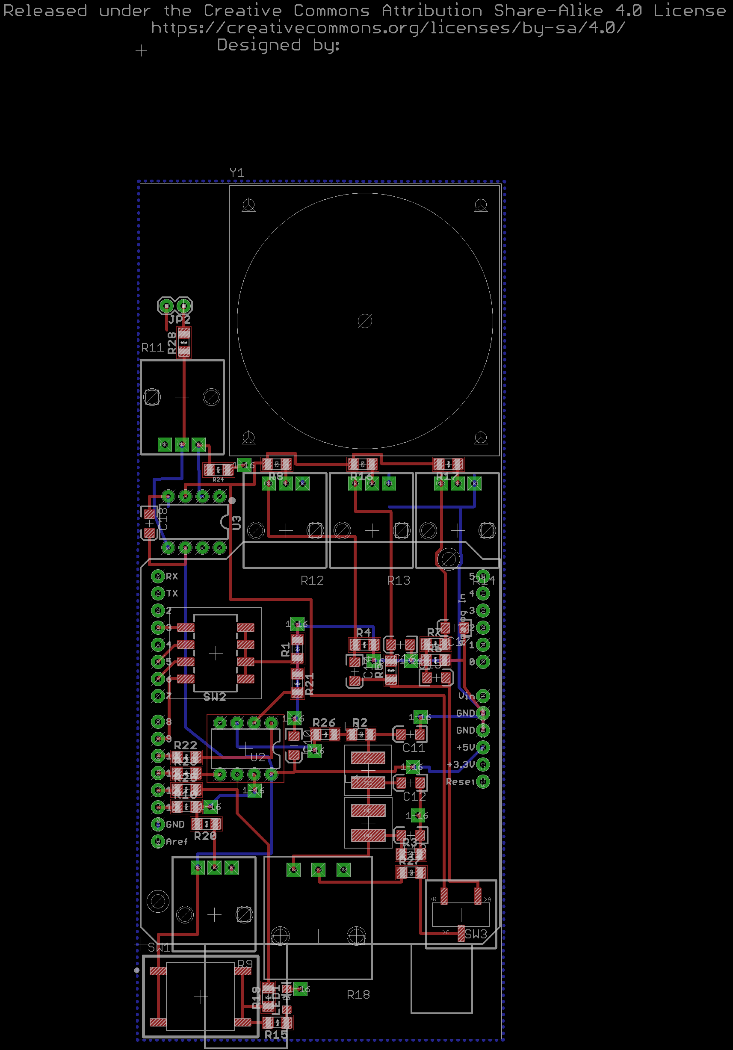
3 Realization/Manufacturing Package/Preview/Layout Rev1.png
