theengineeraccelerator/Arduino-DDS/4 Bring Up/Bring Up Change List.xlsx

Author | Zacher Tiburzi |  | ask malcom if it is bad to short to the top board
Date | 2017-08-06
Project | DDS Tone Shield
Bring Up Change List
Version | Engineer | Issue | Resolution | Documentation Updated
Rev 1 | Zacher Tiburzi | Ther arduino board has more pins than the DDS board, to the headers don’t match up | Add 4 more hols to the layout
Rev 1 | Zacher Tiburzi | Arduino pin rx pin is close to trace above. | Move the trace
Rev 1 | Zacher Tiburzi | Many traces have close calls, with other traces and components | Try to make all layout parts > .5mm apart
Rev 1 | Zacher Tiburzi | The jumpers have too lare of a distance between them. | Remove the 0ohm resistors and place the solder jumpers. The sparkfun library has a library already
Rev 1 | Zacher Tiburzi | The holes on the pots are a little large | Make the holes a little smaller
Rev 1 | Zacher Tiburzi | The inductor pads are a little small, because the pad is under the part and iron cant get at the solder on the pad. | Create larger pads, specifically make them longer
Rev 1 | Zacher Tiburzi | The traces are small | .024 traces to make things fit better
Rev 1 | Zacher Tiburzi | Make sure all the pads align on the schematic | double check the static parts pads. LED
Rev 1 | Zacher Tiburzi | The jumper can short to the top of the board. http://www.delorie.com/pcb/solderjumpers.html | Isolate the jumper so is can have solder added an nmot short to the rest of the board
Rev 1 | Zacher Tiburzi | The push button is always on | double check the button library to make sure the pulldown and pull up network are correctly aligned
Rev 1 | Zacher Tiburzi | IC socket does not look ggos, and conection is tenious. | Buy an IC socket
Rev 1 | Zacher Tiburzi | The pots have extra holder pins, that could caus a short. On all 4 sides, in the middle, for about a third of the length | Make sure not to put a trace and /or update the library
Rev 1 | Zacher Tiburzi | The pot connects into into a1(attiny) and pin13(uno). There is a resistor in the uno pin 13 in parallel with the pot on DDS board that lowers its value. Additionally the pin 13 is the SPI clock, this means the poteomooter is skewing the clock signal ad makinf it unable to program | make the pot frome the a1 to a2 or a3 and mke sure there is nothing else on the line. Like the arduino that had extra resistors
Rev 1 | Zacher Tiburzi | The jumpers are not not easy to jump, and short to the board. | Isolate the jumper so all we need is some solder on the top and not wory about a short. Creae a barrir, possibally iuse the 0402 cap as a template pads layer
Rev 1 | Zacher Tiburzi | The individual 2 jumpers for the speaker will not work because of the sam reason the jumper for IC does not work | Get specific 2 pn jumper that is not hacked
Rev 1 | Zacher Tiburzi
Rev 1 | Zacher Tiburzi
Rev 1 | Zacher Tiburzi
Rev 1 | Zacher Tiburzi
Rev 1 | Zacher Tiburzi
Rev 1 | Zacher Tiburzi
