theengineeraccelerator/Arduino-DDS/4 Bring Up/Rework Tracking.xlsx

Author
Date
Project
Version
Rework Tracking | Board
Issue | 1 | 2 | 3 | 4 | 5 | Version
Header 2 and 3 are switched | Used jumper cable to connect the pins to the correct spots |  |  |  |  |  | Rev 03
5k package overlaps with header 2 | Bent pot to float above the package at a right angle |  |  |  |  |  | Rev 03
Ordered wrong capacitor package size | Used Bipolar 22 uF capacitors instead of 25uf and 20uf |  |  |  |  |  | Rev 03
Capacitor pads are to small for capacitors used on hand | Soldered capacitors at an angle ontop of a pin to the ground plane |  |  |  |  |  | Rev 03
Dip switch input pin not connected to output pin | Used jumper cables to connect to attiny through another pin |  |  |  |  |  | Rev 03
Ground plane that was supposed to connect to capacitor ground is electrically isolated. | Added jump wire to connect ground plane to ground |  |  |  |  |  | Rev 03
