theengineeraccelerator/Arduino-DDS/4 Bring Up/Archive/Bring Up Change List REV 1.xlsx

Author | Douglas Bahr
Date | 2016-11-11
Project | DDS Tone shield
Bring Up Change List
Version | Engineer | Issue | Resolution | Documentation Updated | Time to Complete
REV 1 | Douglas Bahr | POT 5k pads are off | Repad Pot and replace it on board | Arduino DDS shield Rev 6.PcbDoc
REV 1 | Douglas Bahr | POT 100k Pads are off | Repad Pot and replace it on board | Arduino DDS shield Rev 6.PcbDoc
REV 1 | Douglas Bahr | DIP SWITCH pad package is wrong | Figure out where the issue cropped up to note how to avoid it in the future before changing the package size and replaceing the part | DIP switch 8position.lib
REV 1 | Douglas Bahr | Change placement of Via under ON/ON Switch to not be under switch to stop issue of placement of part | Rewire the via | Arduino DDS shield Rev 6.PcbDoc
REV 1 | Douglas Bahr | Anular ring size is too small on all pads /vias | Altium resize the pads/vias | Arduino DDS shield Rev 6.PcbDoc
REV 1 | Douglas Bahr | VIA drill size not complient with 22 guage wire | Change Sizes in altium | Arduino DDS shield Rev 6.PcbDoc
REV 1 | Douglas Bahr | DDS Filter design layout is messy | Replace pads and retrace the lines | Arduino DDS shield Rev 6.PcbDoc
REV 1 | Douglas Bahr | DDS filter change pad/part sizes for easier reworking | Replace pads or modify pads after placement | Arduino DDS shield Rev 6.PcbDoc
REV 1 | Douglas Bahr | Board outline trace exists | Figure out problem and remove it | Arduino DDS shield Rev 6.PcbDoc
REV 1 | Douglas Bahr | Resister/led is in wrong order | Switch in sketch then replace in document | Arduino DDS Shield Rev 6.SchDoc
REV 1 | Douglas Bahr | Sketch is wrong with connection to VCC POT 100k | Change part library and update schematic | Arduino DDS Shield Rev 6.SchDoc
REV 1 | Douglas Bahr | Layout is wrong with connection to VCC POT 100k | Replace and retrace part in layout | Arduino DDS shield Rev 6.PcbDoc
REV 1 | Douglas Bahr | No test points/hard to debug | Add test points and other connections directly to board layout | Arduino DDS shield Rev 6.PcbDoc
REV 1 | Douglas Bahr | Change Solder Mount components to bottom layer | Move each solder mount component to bottom layer | Arduino DDS shield Rev 6.PcbDoc | 4:24:00 | Hours
REV 2 | Douglas Bahr | Change Board outline for attiny85 input pin to pin 7 (rx pin on attiny)
REV 2 | Douglas Bahr | Change the 3&2 header placement on the board outline and retrace board
REV 2 | Douglas Bahr | Change the pad libarary of the 8 DIP switch so signals coming in connect across to the pads going out
REV 2 | Douglas Bahr | Change Chebyshev filter values to coincide with Product def
REV 2 | Douglas Bahr | Add in Audio Amp for small signal output
REV 2 | Douglas Bahr | Source better 100k POT that has a plunger
REV 2 | Douglas Bahr | Change placement of 5k POT due to placement conflicts
REV 2 | Douglas Bahr | Create hole for speaker housing and source glue to keep speaker in place
REV 2 | Douglas Bahr | Add programming header into board for easier prototyping
REV 2 | Douglas Bahr | Make sure all ground planes are connected and not isolated
REV 2 | Douglas Bahr | Add blocking capacitor to remove DC signal offset post Filter
REV 2 | Douglas Bahr | Product definition rework to coincide with design [LED is controlled by microcontroller and not just the state switch]
REV 2 | Douglas Bahr | Bring up code to accurately have a frequency equal 1-1 to output frequency
REV 2 | Douglas Bahr | Code currently cuts off at around 5kHz
1
1
1
1 |  | arduino pin rx is close to wire above. .5mm make larger
1 |  | pins along 9 8 arduino are close .3mm
1
1
1 |  |  | pots have the holders so don’t short. At the sides of all 4 sidesin the middle about a third of the way
1
1
1
1
1
1 |  | Remove the 0ohm resistors and place the solder jumpers. The sparkfun library has a library already
 |  | the current arduino library is missing 2 hold on each side, add this and we will have an easier connection the board
 |  | make the components seperated by .6 min or prefered 1mm trace to get rid of all the iffy situations
 |  | make the components seperated by .6 min or prefered 1mm trace to get rid of all the iffy situations
 |  | double check the button switch new library look
 |  | ic socket to buy
 |  | Make sure all the pads align on the schematic | double check the static parts pads. LED
 |  | The traces are small | .024 traces to make things fit better
 |  | ask malcom if it is bad to short to the top board
 |  | The pot into a1? Is in parrallel with the internal schematic on the aruino. It is also on the clock line, this means the it values sen on the line re skewed. | Make the pot on PB2 moved over to another eual signal. | make the pot frome the a1 to a2 or a3 and mke sure there is nothing else on the line. Like the arduino that had extra resistors
 |  | The inductor pads are a little small, because the pad is under the part and iron cant get at the solder. | Create larger pads, specifical0ly make them longer
 |  | The holes on the pots are a little large | Make the holes a little smaller
