theengineeraccelerator/Arduino-DDS/5 Test/Arduino code Note = 1000 Test/Post Chebyshev filter/1000_Code_126 hz in_ Post chebyshev Filter FFT 1khz.png

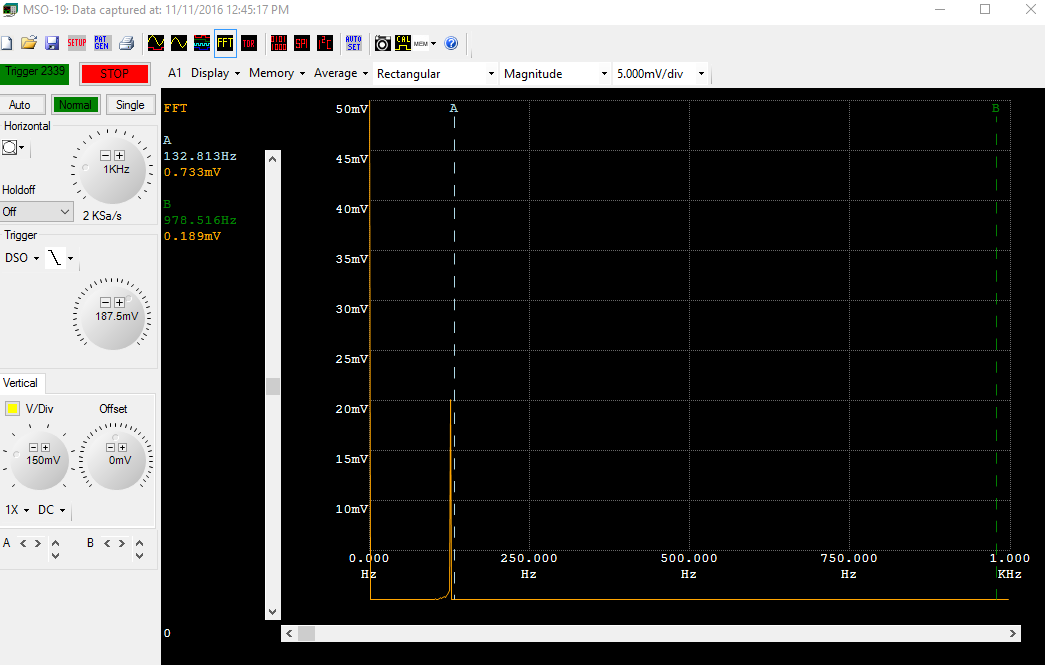
5 Test/Arduino code Note = 1000 Test/Post Chebyshev filter/1000_Code_126 hz in_ Post chebyshev Filter FFT 1khz.png
