theengineeraccelerator/Arduino-DDS/5 Test/Arduino code Note = 1000 Test/Post RC/1000_Code_126 hz in_ Post Rc Filter.png

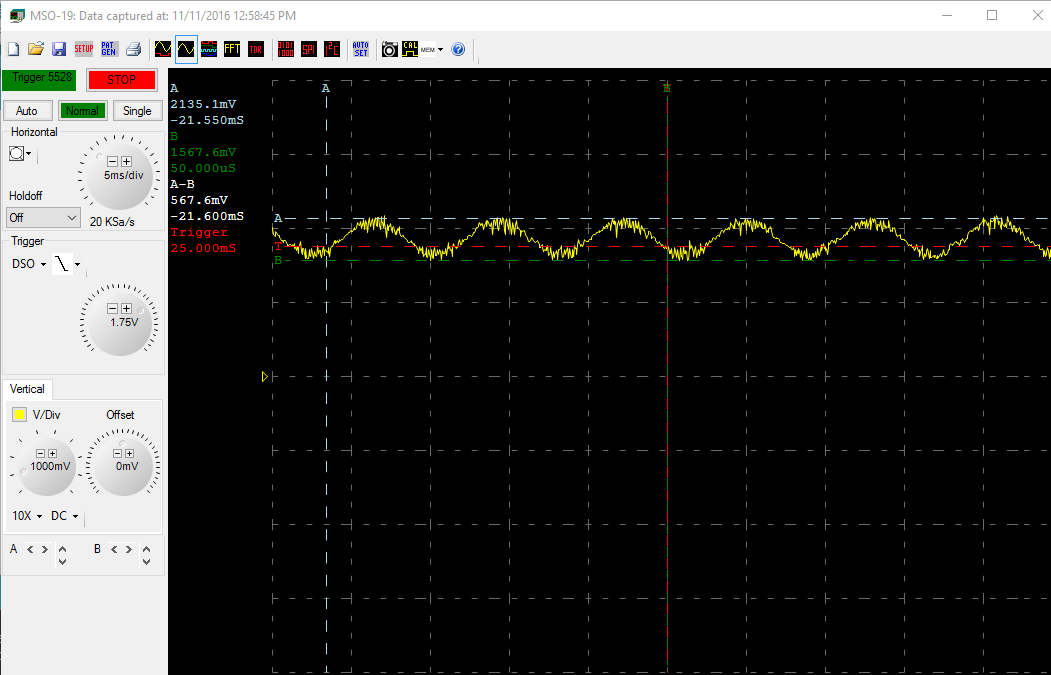
5 Test/Arduino code Note = 1000 Test/Post RC/1000_Code_126 hz in_ Post Rc Filter.png
