theengineeraccelerator/Arduino-DDS/5 Test/Arduino code Note = 1000 Test/Pre Filter/1000_Code_126 hz in PreFilter FFT 1khz .png

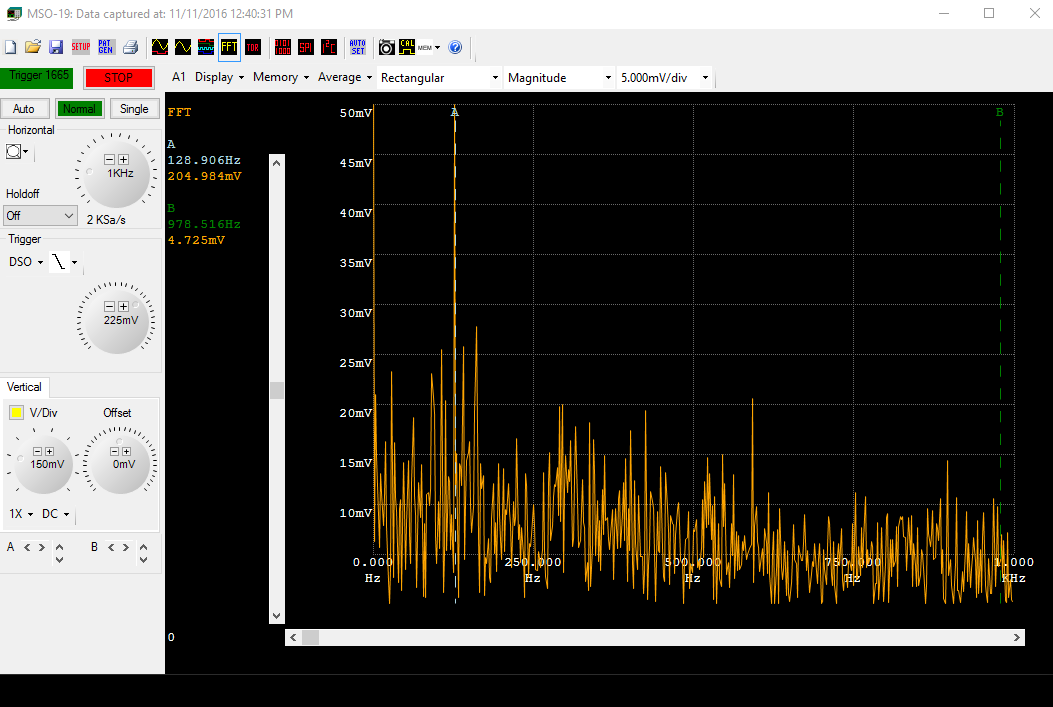
5 Test/Arduino code Note = 1000 Test/Pre Filter/1000_Code_126 hz in PreFilter FFT 1khz .png
