theengineeraccelerator/Arduino-DDS/2 Architecture/Hardware Block Diagram.pdf

# Arduino Uno DDS Tone Board Hardware Block Diagram

# Introduction

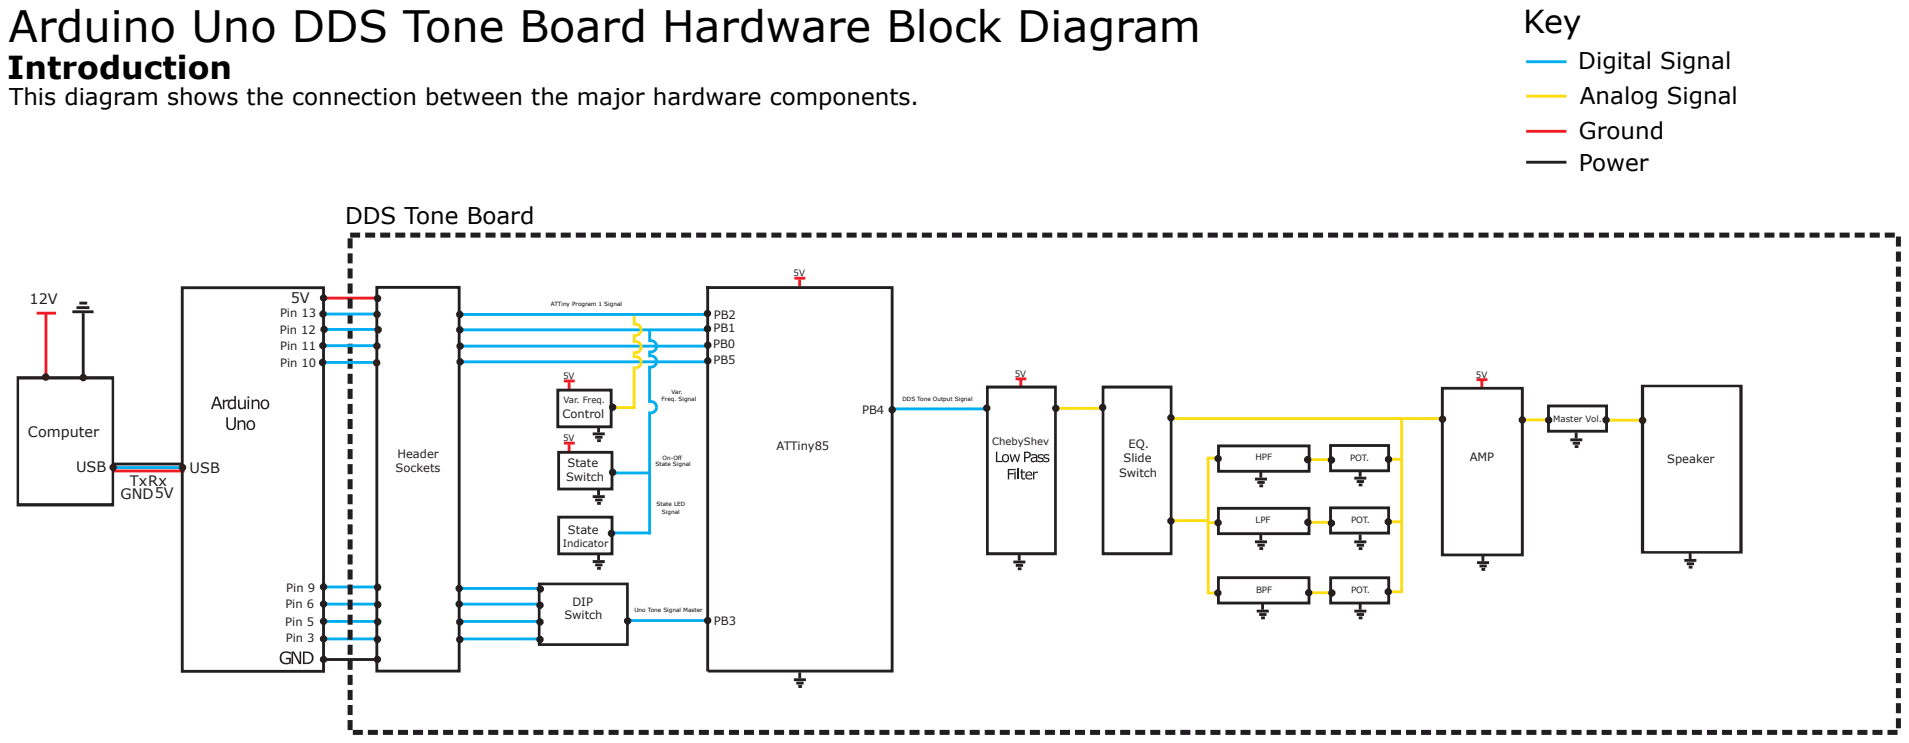
[picture p16: page 1]
State Signal; Slide Switch; HPF; AMP; Computer; TxRx; LPF; BPF; GND5V; USB; Pin 13 Pin 12 Pin 11 Pin 10; Pin 9 Pin 6 Pin 5 Pin 3; DIP Switch; ATTiny85; Var. Freq.; State Switch; POT.; Speaker; Master Vol.; State LED Signal; On-Off; Freq. Signal; Var.; Header Sockets; ChebyShev; Control; State Indicator; Key; Digital Signal Analog Signal; Power; Ground

This diagram shows the connection between the major hardware components.

DDS Tone Board

ATTiny Program 1 Signal

DDS Tone Output Signal

Uno Tone Signal Master
