theengineeraccelerator/Arduino-DDS/2 Architecture/Firmware Block Diagram.pdf

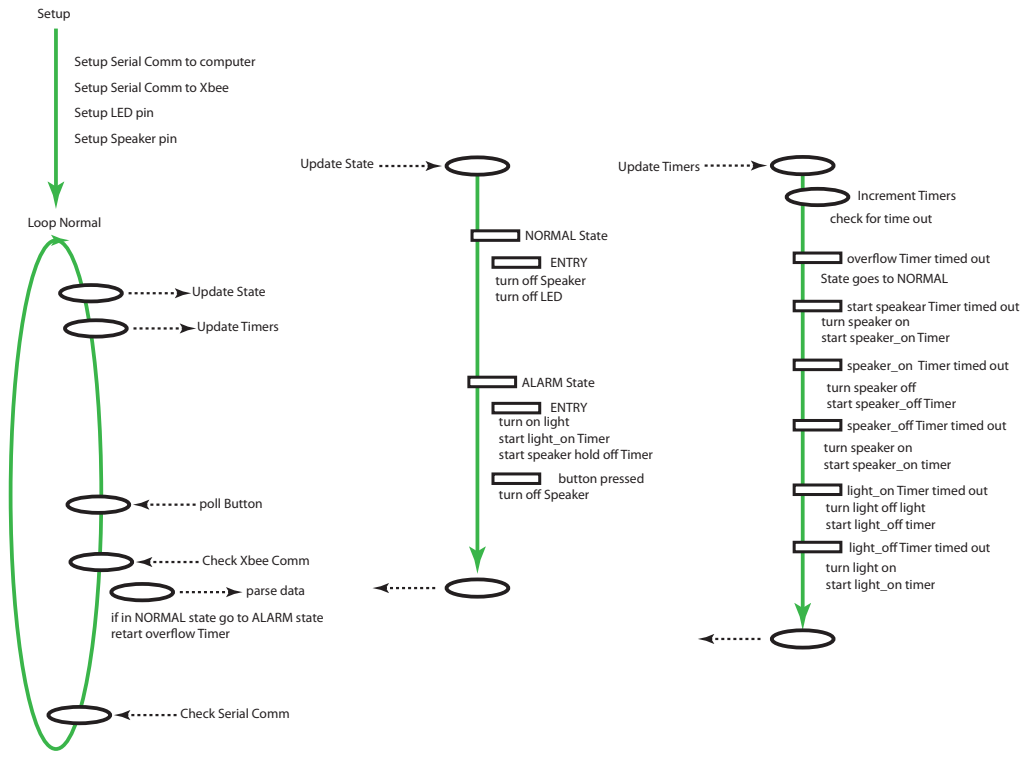
[picture p17: page 1]
Setup; Loop Normal; Update State; NORMAL State; ALARM State; Update Timers; poll Button; ENTRY; button pressed; turn o Speaker; light_on Timer timed out; turn o Speaker turn o LED

Setup Serial Comm to computer
Setup Serial Comm to Xbee
Setup LED pin
Setup Speaker pin

Increment Timers
check for time out

overow Timer timed out
State goes to NORMAL
start speakear Timer timed out
turn speaker on
start speaker_onTimer
speaker_on Timer timed out
turn speaker o
start speaker_o Timer
speaker_o Timer timed out
start speaker_on timer

turn on light
start light_on Timer
start speaker hold o Timer

turn light o light
start light_o timer
light_o Timer timed out
turn light on
start light_on timer

Check Xbee Comm
parse data

if in NORMAL state go to ALARM state
retart overow Timer

Check Serial Comm
