theengineeraccelerator/Arduino-DDS/1 Product Definition/Feature Block Diagram Rev_3_5-16-2017.pdf

# DDS Tone Shield Feature Block Diagram Key

# Author Zacher Tiburzi

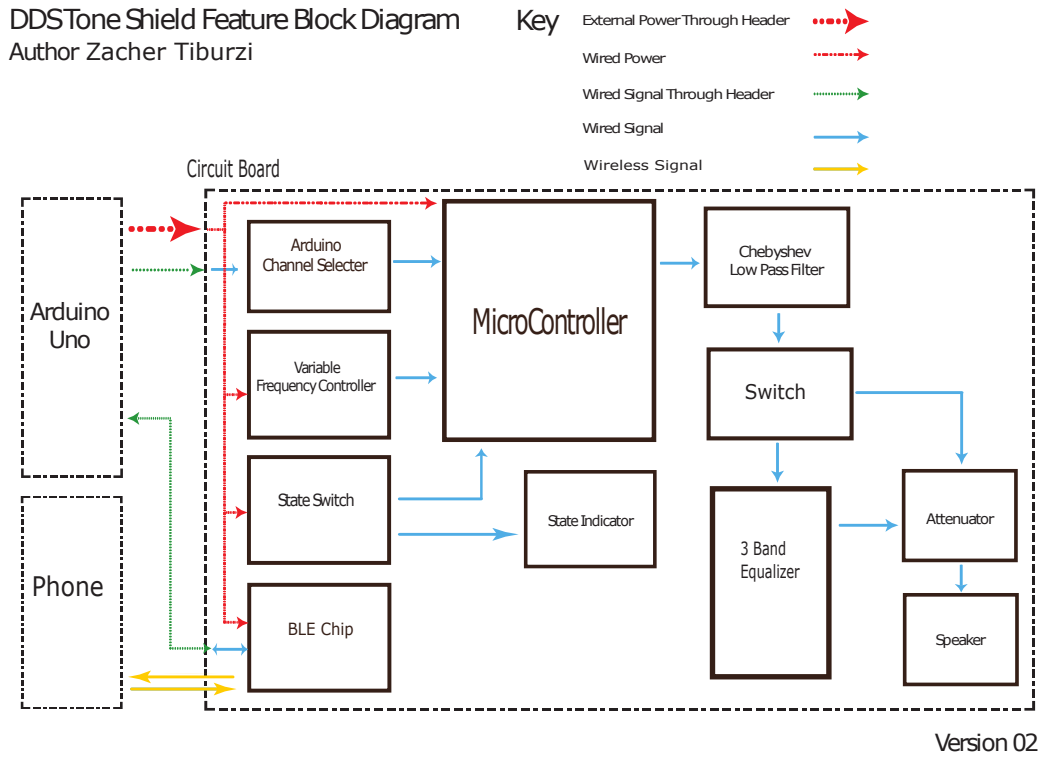
[picture p18: page 1]
MicroController; Speaker; Arduino Uno; Attenuator; Arduino Channel Selecter; State Switch; Variable Frequency Controller; State Indicator; Wired Power; Wired Signal; Version 02; BLE Chip; Circuit Board; Switch; 3 Band Equalizer Phone; Wireless Signal

External Power Through Header

Wired Signal Through Header

Chebyshev
Low Pass Filter
