theengineeraccelerator/Arduino-DDS/2 Architecture/Archive/Hardware Block Diagram Template.pdf

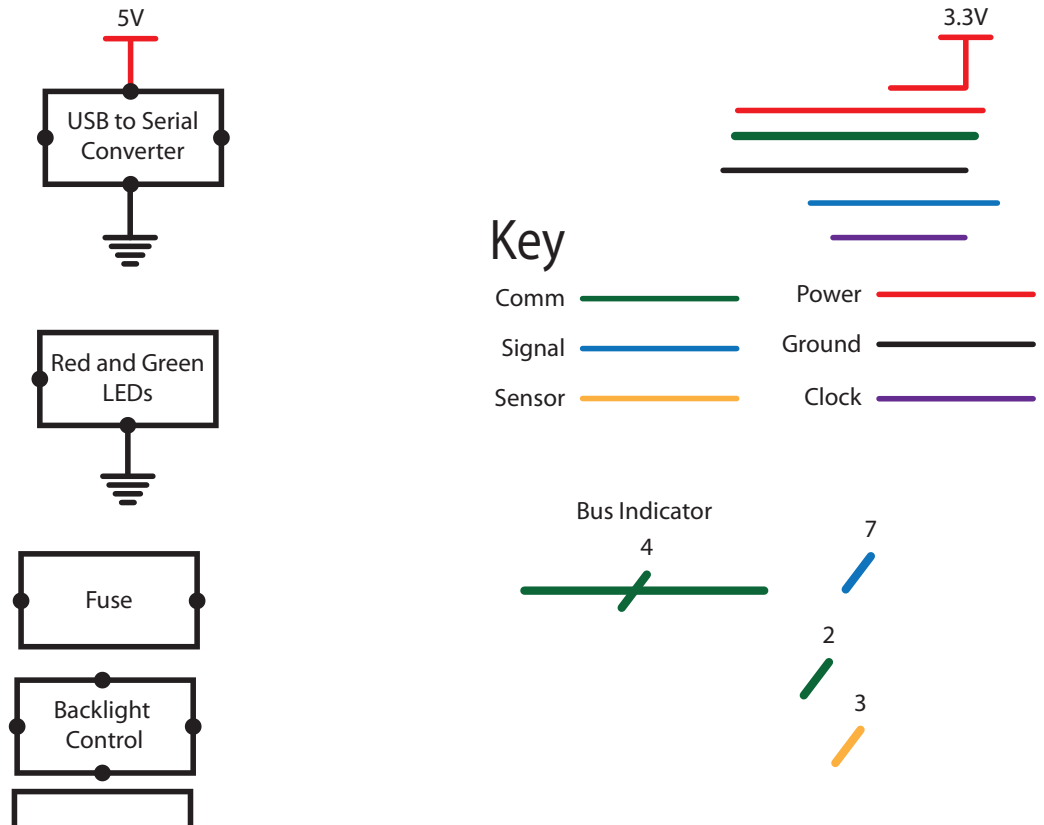
[picture p19: page 1]
Fuse; Backlight Control; Key; Signal; Power; Ground; Sensor; Bus Indicator; Comm; Clock

USB to Serial
Converter

Red and Green
LEDs
