theengineeraccelerator/Arduino-DDS/(list of files, drawings)

Other design files:
3 Realization/Archive 1/Arduino DDS shield Rev 5.PcbDoc
3 Realization/Archive 1/Arduino DDS Shield Rev 5.SchDoc
3 Realization/Archive 1/ArduinoUnoShield.SchDoc
3 Realization/Archive 1/DDS Shield rev 2.PrjPcb
3 Realization/Archive 1/DDSSHEILD_rev_04.PcbDoc
3 Realization/Archive 1/DDSShieldBoard.PcbDoc
3 Realization/Archive 2/Arduino DDS shield Rev 6.PcbDoc
3 Realization/Archive 2/Arduino DDS Shield Rev 6.SchDoc
3 Realization/Arduino DDS shield Rev 6.PcbDoc
3 Realization/Arduino DDS Shield Rev 6.SchDoc
3 Realization/ArduinoUnoShield.SchDoc
3 Realization/DDSSHEILD_rev_04.PcbDoc
3 Realization/DDSShieldBoard.PcbDoc
4 Realization/ArduinoUnoShield.SchDoc
4 Realization/DDSShieldBoard.PcbDoc
