theengineeraccelerator/Arduino-DDS/3 Realization/Manufacturing Package/Layout and Schematic/DDS Tone Shield/DDS Tone Shield.brd

## EAGLE design 3 Realization/Manufacturing Package/Layout and Schematic/DDS Tone Shield/DDS Tone Shield.brd (2017-08-05)

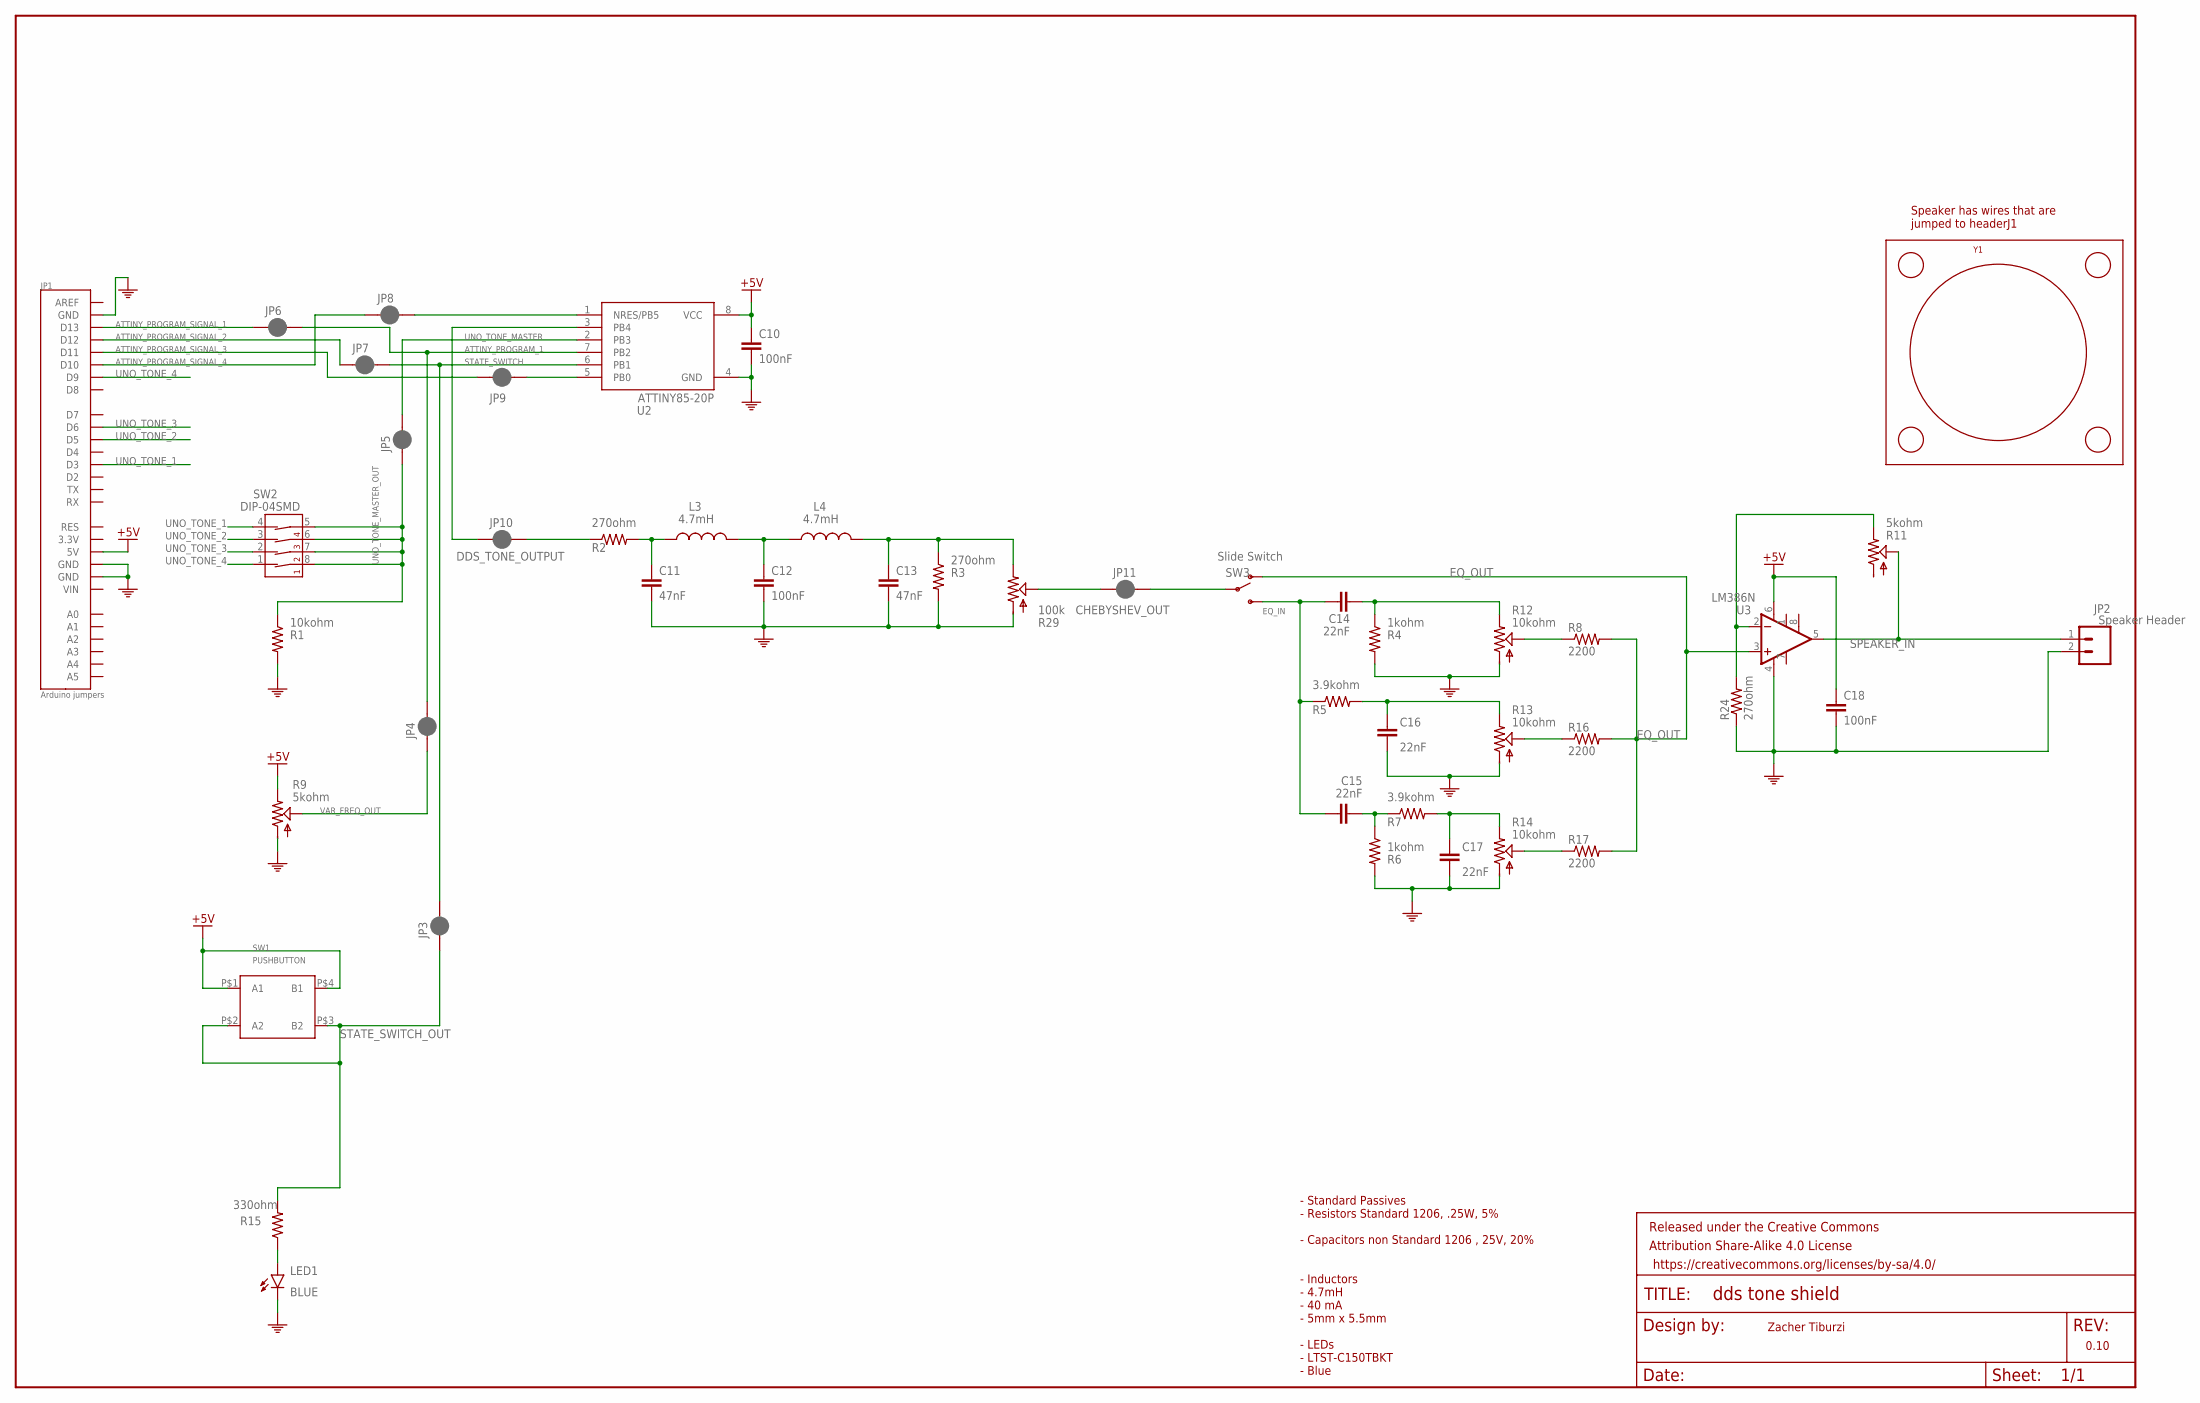
[picture p20: schematic DDS Tone Shield.sch]

Parts:
C10, C12, C18: 100nF; EIA3216
C11, C13: 47nF; EIA3216
C14, C15, C16, C17: 22nF; EIA3216
FRAME2: FRAME-LEDGER; CREATIVE_COMMONS
JP1: Arduino jumpers; DUEMILANOVE_SHIELD
JP2: Speaker Header; 1X02
JP3, JP4, JP5, JP6, JP7, JP8, JP9, JP10, JP11: JUMPER-SMT_2_NC_PASTE_SILK; SMT-JUMPER_2_NC_PASTE_SILK
L3, L4: 4.7mH; SDR0503-472JL
LED1: BLUE; LED-1206
R1: 10kohm; 1206
R2, R3, R24: 270ohm; 1206
R4, R6: 1kohm; 1206
R5, R7: 3.9kohm; 1206
R8, R16, R17: 2200; 1206
R9, R11: 5kohm; RK09K/RK09D_SERIES
R12, R13, R14: 10kohm; RK09K/RK09D_SERIES
R15: 330ohm; 1206
R29: 100k; RK09K/RK09D_SERIES
SW1: PUSHBUTTON; 3CSH9_MEC_PUSHBUTTON
SW2: DIP-04SMD; DIPSWITCH-04-SMD
SW3: Slide Switch; JS102011SAQN
U2: ATTINY85-20P; PDIP08_300MIL
U3: LM386N; DIP08
Y1: Speaker; CSS-40408N

Connections:
+5V: C10.A (1), C18.A (1), JP1.5V, R9.P$3 (E), SW1.P$1 (A1), SW1.P$4 (B1), U2.8 (VCC), U3.6 (V+)
AMP_NEG: R11.P$3 (E), R24.2, U3.2 (-IN)
ATTINY_PROGRAM_1: JP4.2, JP6.2, U2.7 (PB2)
ATTINY_PROGRAM_SIGNAL_1: JP1.D13, JP6.1
ATTINY_PROGRAM_SIGNAL_2: JP1.D12, JP7.1
ATTINY_PROGRAM_SIGNAL_3: JP1.D11, JP9.1
ATTINY_PROGRAM_SIGNAL_4: JP1.D10, JP8.1
BPF_ATTENUATED: R14.P$2 (S), R17.1
BPF_INTERMEDIATE: C15.C (2), R6.1, R7.1
BPF_OUT: C17.A (1), R7.2, R14.P$3 (E)
CHEBYSHEV_IN: JP10.2, R2.1
CHEBYSHEV_OUT: JP11.1, R29.P$2 (S)
CHEBYSHEV_STAGE_1: C11.A (1), L3.P$1 (1), R2.2
CHEBYSHEV_STAGE_2: C12.A (1), L3.P$2 (2), L4.P$1 (1)
CHEBYSHEV_STAGE_3: C13.A (1), L4.P$2 (2), R3.1, R29.P$3 (E)
DDS_TONE_OUTPUT: JP10.1, U2.3 (PB4)
EQ_IN: C14.A (1), C15.A (1), R5.1, SW3.P$1 (S)
EQ_OUT: R8.2, R16.2, R17.2, SW3.P$2 (O), U3.3 (+IN)
GND: C10.C (2), C11.C (2), C12.C (2), C13.C (2), C16.C (2), C17.C (2), C18.C (2), JP1.GND@0 (GND), JP1.GND@1 (GND), JP1.GND@2 (GND), JP2.2, LED1.C, R1.2, R3.2, R4.2, R6.2, R9.P$1 (A), R12.P$1 (A), R13.P$1 (A), R14.P$1 (A), R24.1, R29.P$1 (A), U2.4 (GND), U3.4 (V-)
HPF_ATTENUATED: R8.1, R12.P$2 (S)
HPF_OUT: C14.C (2), R4.1, R12.P$3 (E)
LED_POSITIVE: LED1.A, R15.1
LPF_ATTENUATED: R13.P$2 (S), R16.1
LPF_OUT: C16.A (1), R5.2, R13.P$3 (E)
PROGRAM3: JP9.2, U2.5 (PB0)
PROGRAM4: JP8.2, U2.1 (NRES/PB5)
SLIDE_SWITCH_IN: JP11.2, SW3.P$3
SPEAKER_IN: JP2.1, R11.P$2 (S), U3.5 (OUT)
STATE_SWITCH: JP3.2, JP7.2, U2.6 (PB1)
STATE_SWITCH_OUT: JP3.1, R15.2, SW1.P$2 (A2), SW1.P$3 (B2)
UNO_TONE_1: JP1.D3, SW2.4 (4A)
UNO_TONE_2: JP1.D5, SW2.3 (3A)
UNO_TONE_3: JP1.D6, SW2.2 (2A)
UNO_TONE_4: JP1.D9, SW2.1 (1A)
UNO_TONE_MASTER: JP5.2, U2.2 (PB3)
UNO_TONE_MASTER_OUT: JP5.1, R1.1, SW2.5 (4B), SW2.6 (3B), SW2.7 (2B), SW2.8 (1B)
VAR_FREQ_OUT: JP4.1, R9.P$2 (S)

Notes on the sheet:
Zacher Tiburzi
Speaker has wires that are jumped to headerJ1
- Standard Passives - Resistors Standard 1206, .25W, 5% - Capacitors non Standard 1206 , 25V, 20% - Inductors - 4.7mH - 40 mA - 5mm x 5.5mm - LEDs - LTST-C150TBKT - Blue

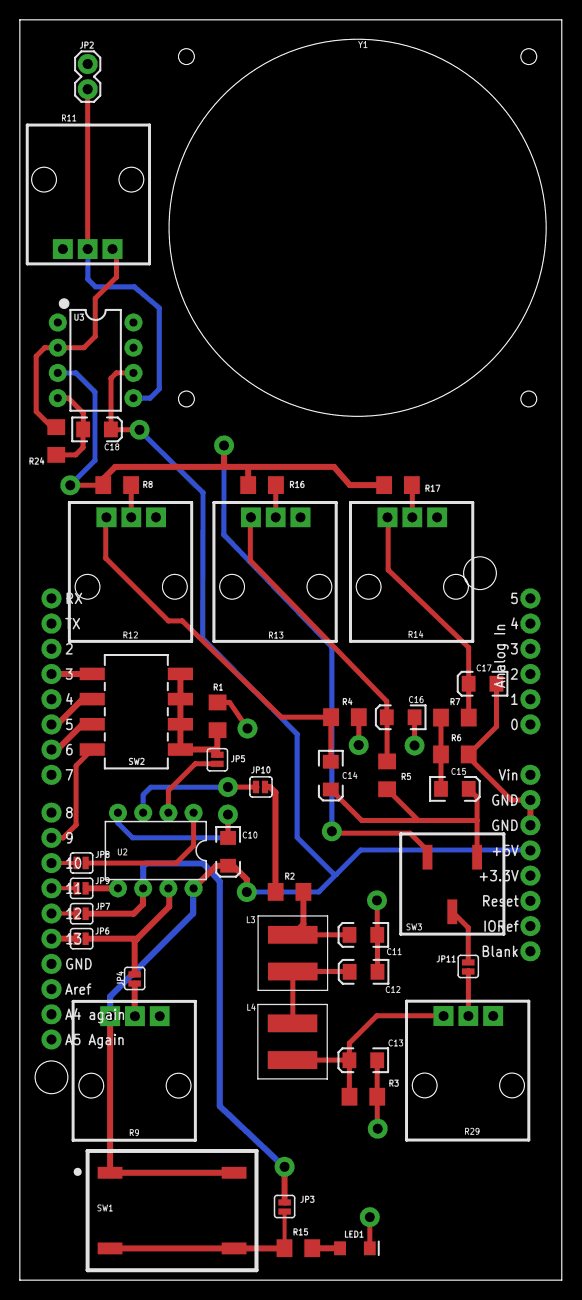
[picture p21: board DDS Tone Shield.brd from above]

Board: 2 copper layers, 54.6 x 127.0 mm, 48 parts (0 on the bottom side), 37 nets.
