theengineeraccelerator/Arduino-DDS/(commit log)

2016-10-17 Moving project to general project folder
    [ArduinoUnoShield.SchDoc, ArduinoUnoShield.dwg, ArduinoUnoShield.sch, DDS Tone Shield Major Component BOM REV 02.xlsx, DDS Tone Shield Major Component BOM REV 03.xlsx, DDSShieldBoard.PcbDoc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]
2016-10-18 Time estimate
    Initial time estimate for future work without Testing filled in
    [Time Estimate.xlsx]
2016-10-20 Updated Repository; Overhauled timesheet estimate
    [ArduinoUnoShield.SchDoc, ArduinoUnoShield.dwg, ArduinoUnoShield.sch, Bring Up Change List REV 1.xlsx, Bring Up Change List.xlsx, DDSShieldBoard.PcbDoc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]
2016-10-20 Updated Folder Structure
    [ArduinoUnoShield.SchDoc, ArduinoUnoShield.dwg, ArduinoUnoShield.sch, Bring Up Change List REV 1.xlsx, Bring Up Change List.xlsx, DDSShieldBoard.PcbDoc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]
2016-10-20 Different version of PCDDOC laptop
    [DDSSHEILD_rev_04.PcbDoc]
2016-10-20 Bring up for board 2 complete
    [Arduino DDS Shield Rev 5.SchDoc, Arduino DDS Shield Rev 6.SchDoc, Arduino DDS shield Rev 5.PcbDoc, Arduino DDS shield Rev 6.PcbDoc, ArduinoUnoShield.SchDoc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]
2016-11-11 Updated realization folder wtih higher Shield Revs and other MSC files
    [Arduino DDS Shield Rev 5.SchDoc, Arduino DDS Shield Rev 6.SchDoc, Arduino DDS shield Rev 6.PcbDoc, BOM__rev_2.xlsx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]
2016-11-11 Added Test Writeup, Code for attiny
    Added base firmware for attiny85 under architecture.
    Added a single point test writeup for signal seen.
    Added screenshots of signals to show what was generated.
    Commented code
    [BOM__rev_2.xlsx, Bring Up Change List REV 1.xlsx, Bring Up Change List.xlsx, DDS Tone Shield Major Component BOM REV 03.xlsx, Rework Tracking.xlsx, Time Estimate Rev 2.xlsx, Time Estimate Rev 3.xlsx, Time Estimate Rev 4.xlsx]
2017-05-23 Architecture
    Major update to the Architecture files.
    [DDS Tone Shield Major Component BOM REV 03.xlsx, Major Component BOM.xlsx, Product Architecture REV 02.xlsx, Product Architecture.xlsx]
2017-05-30 Architecture Update
    Architecture Update
    [Major Component BOM.xlsx, Product Architecture.xlsx]
2017-06-27 archatecture / realization
    Clean up the archatecture and work done to the relization
    [DDS Tone Shield.brd, DDS Tone Shield.sch, Major Component BOM.xlsx, Product Architecture.xlsx]
2017-07-08 layout changes
    Layout changes and BOM additions
    [Major Component BOM.xlsx, Product Architecture.xlsx]
2017-07-08 Layout changes again
    Layout changes again
    [DDS Tone Shield.brd, DDS Tone Shield.sch]
2017-07-16 Layout changes
    Layout changes
    [Arduino DDS Shield Rev 5.SchDoc, Arduino DDS Shield Rev 6.SchDoc, Arduino DDS shield Rev 5.PcbDoc, Arduino DDS shield Rev 6.PcbDoc, ArduinoUnoShield.SchDoc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]
2017-08-05 layout
    layout
    [Bring Up Change List REV 1.xlsx, DDS Tone Shield.brd, DDS Tone Shield.sch, Major Component BOM.xlsx, Product Architecture.xlsx]
2017-09-01 doneeeeeeeeeeeeeeeeeeeeeeee???????????:) :(
    [Bring Up Change List REV 1.xlsx, Bring Up Change List.xlsx, DDS Tone Shield.brd, DDS Tone Shield.sch, Major Component BOM.xlsx, Rework Tracking d.xlsx, Rework Tracking.xlsx]
