theengineeraccelerator/Arduino-DDS/(notices)

Notices in the files:
parts and their libraries:
1-Generic: Released under the Creative Commons Attribution Share-Alike 4.0 License
1-Generic: https://creativecommons.org/licenses/by-sa/4.0
1-Generic: Released under the Creative Commons
